TRANQUOCHUY202/DATN/ppDATN.pdf

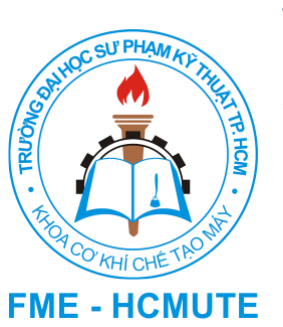
[picture p1: figure]
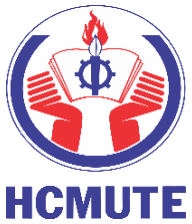
[picture p2: figure]

# ĐỀ TÀI: THIẾT KẾ, CHẾ TẠO BO MẠCH GIÁM SÁT NHIỆT ĐỘ VÀ ĐỘ ẨM CHO BUỒNG HẤP

### TRƯỜNG ĐẠI HỌC SƯ PHẠM KỸ THUẬT TP.HỒ CHÍ MINH KHOA CƠ KHÍ CHẾ TẠO MÁY BỘ MÔN CƠ ĐIỆN TỬ

## ĐỒ ÁN TỐT NGHIỆP

Sinh viên thực hiện:
Trần Hạo Đông Trần Quốc Huy Trương Đình Như | --- | 20146166 20146495 20146509

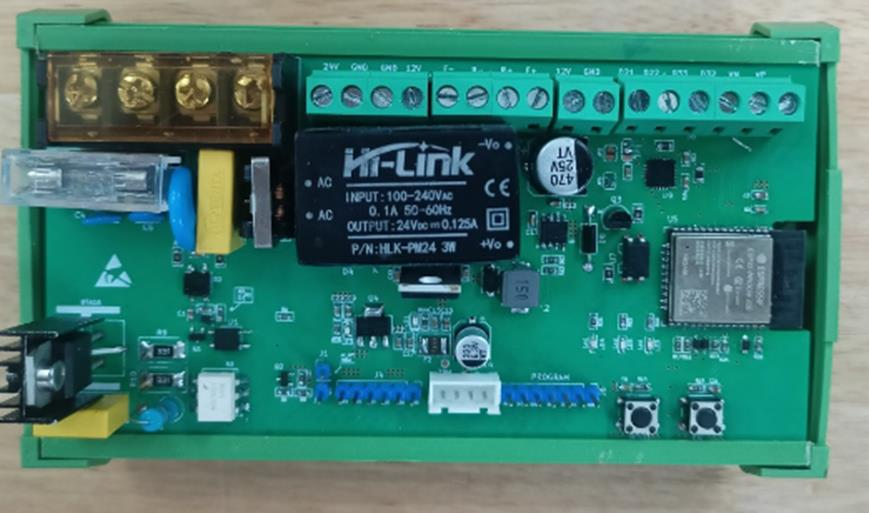
[picture p3: figure]

Tp. Hồ Chí Minh – Tháng 07/2024

Giảng viên hướng dẫn: ThS Dương Thế Phong

## NỘI DUNG THỰC HIỆN

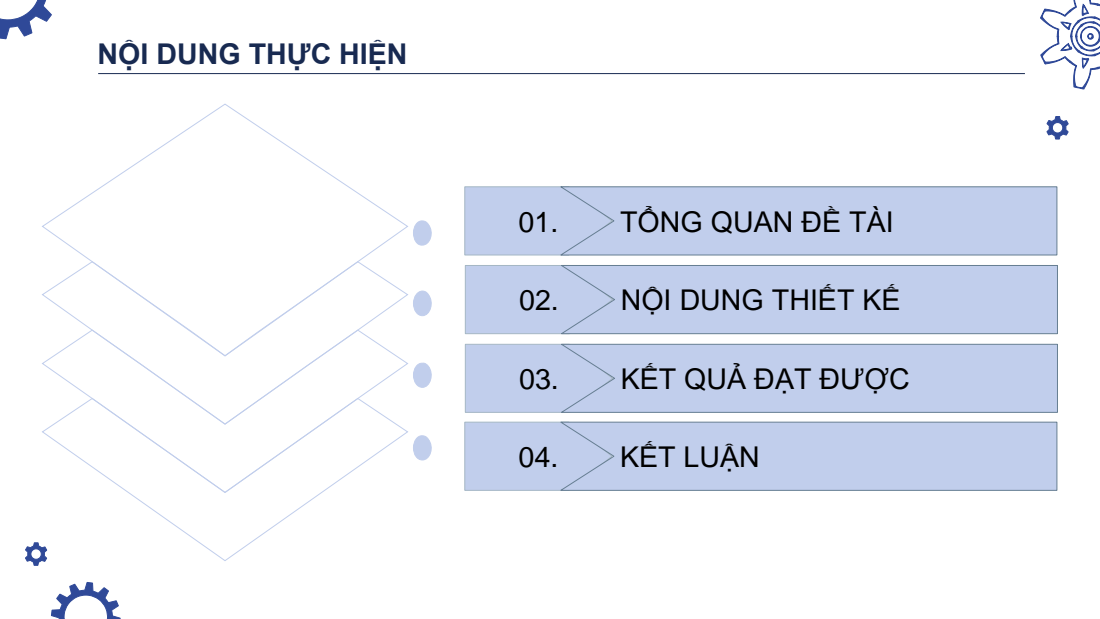
[picture p4: page 2]
04. KẾT LUẬN

01. TỔNG QUAN ĐỀ TÀI

02. NỘI DUNG THIẾT KẾ

03. KẾT QUẢ ĐẠT ĐƯỢC

## 01. TỔNG QUAN ĐỀ TÀI

Tổng Quan

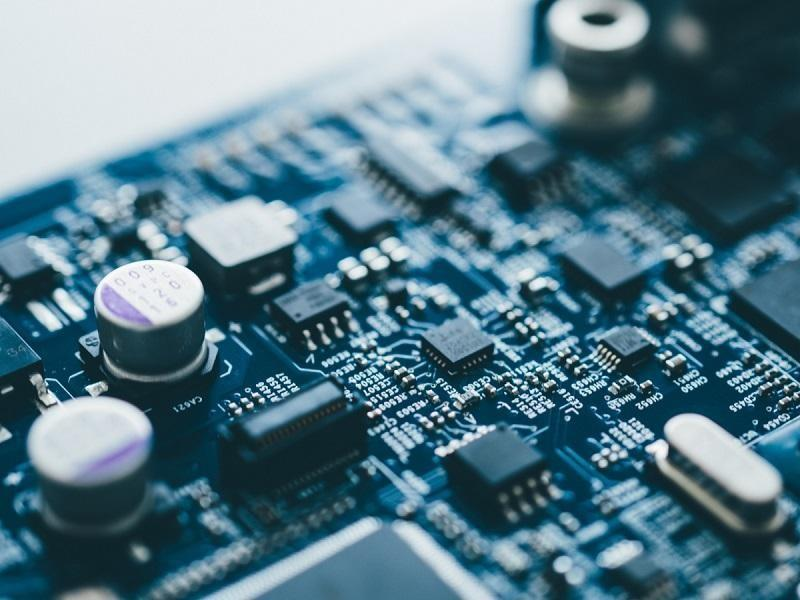
[picture p5: figure]

## 01. TỔNG QUAN ĐỀ TÀI

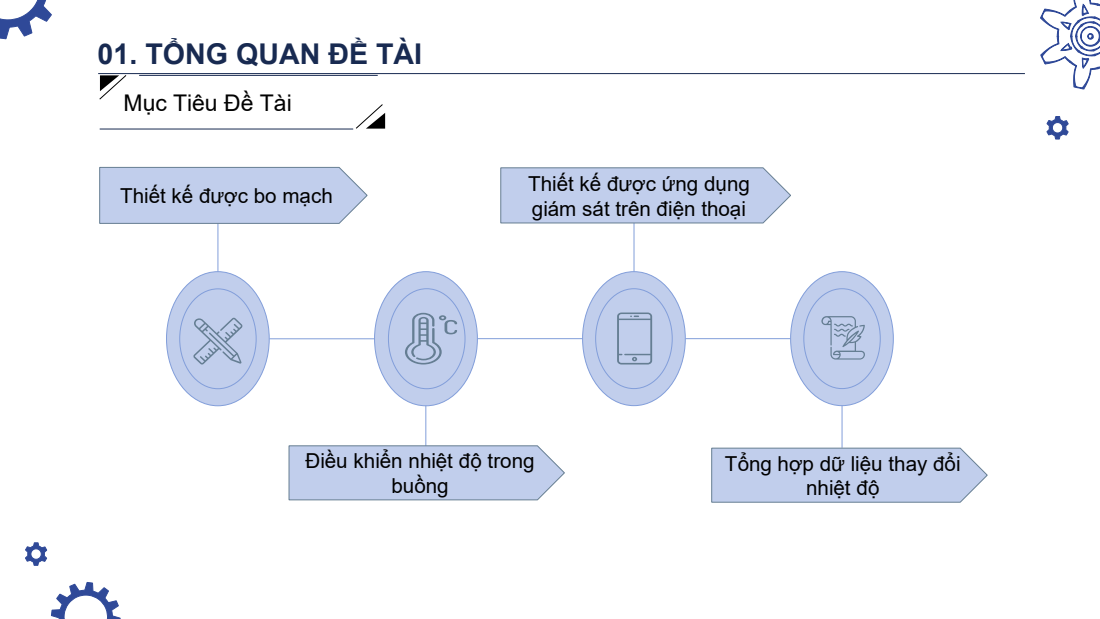
[picture p6: page 4]
buồng; nhiệt độ

Mục Tiêu Đề Tài

Thiết kế được ứng dụng
giám sát trên điện thoại

Thiết kế được bo mạch

Điều khiển nhiệt độ trong

Tổng hợp dữ liệu thay đổi

## 01. TỔNG QUAN ĐỀ TÀI

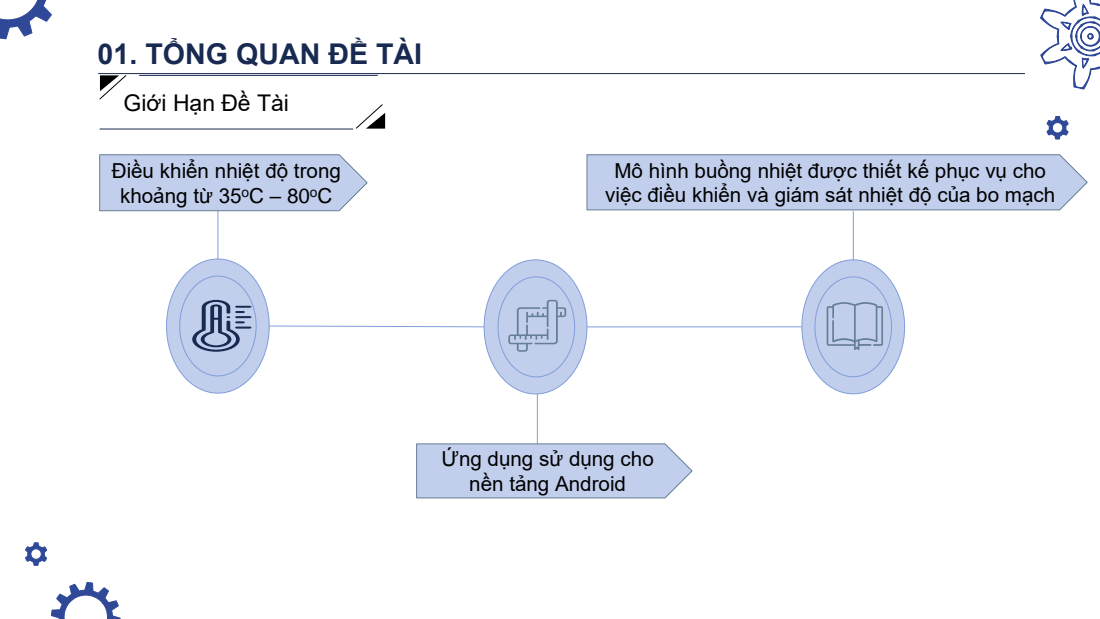
[picture p7: page 5]

Giới Hạn Đề Tài

Điều khiển nhiệt độ trong
khoảng từ 35oC – 80oC

Mô hình buồng nhiệt được thiết kế phục vụ cho
việc điều khiển và giám sát nhiệt độ của bo mạch

Ứng dụng sử dụng cho
nền tảng Android

## 02. NỘI DUNG THIẾT KẾ

Phương Án Thiết Kế

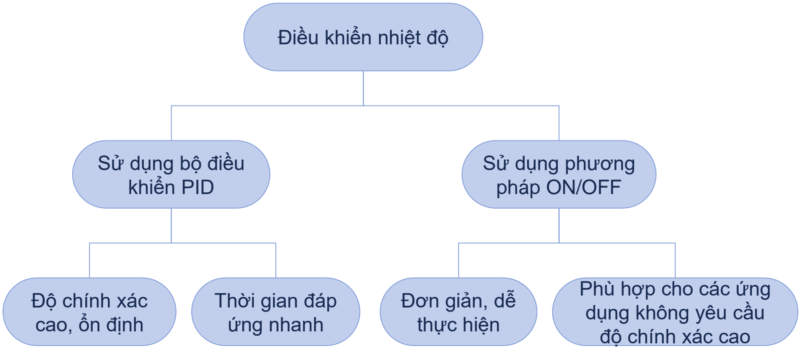
[picture p8: figure]
Độ chính xác cao, ổn định; Thời gian đáp ứng nhanh; Đơn giản, dễ thực hiện; Phù hợp cho các ứng dụng không yêu cầu độ chính xác cao; Sử dụng phương pháp ON/OFF; Sử dụng bộ điều khiển PID; Điều khiển nhiệt độ

## 02. NỘI DUNG THIẾT KẾ

Mô Hình Buồng Nhiệt

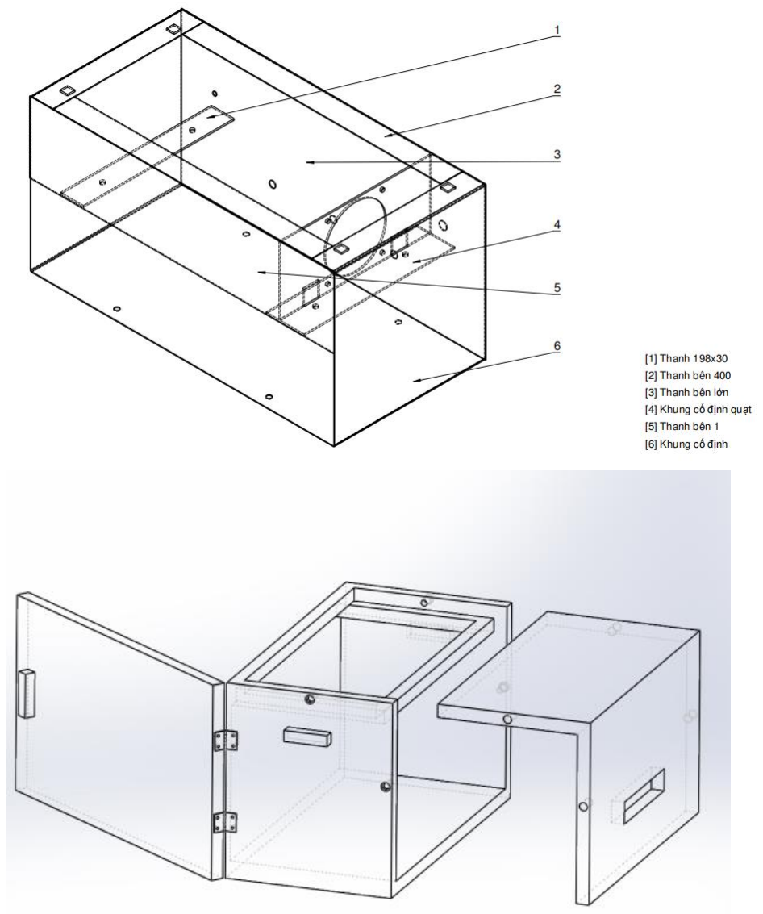
[picture p9: figure]

Mô hình được thiết kế với 3 lớp:

- Lớp vỏ trong: được làm bằng kim loại chịu nhiệt, nơi diễn ra quá trình gia nhiệt.
- Lớp cách nhiệt: Nằm giữa lớp vỏ trong và vỏ ngoài, có chức năng cách nhiệt môi trường bên trong với bên ngoài.
- Lớp vỏ ngoài: Vỏ ngoài được làm từ gỗ đã qua xử lí, đóng góp thêm vào việc cách nhiệt cho buồng.

## 02. NỘI DUNG THIẾT KẾ

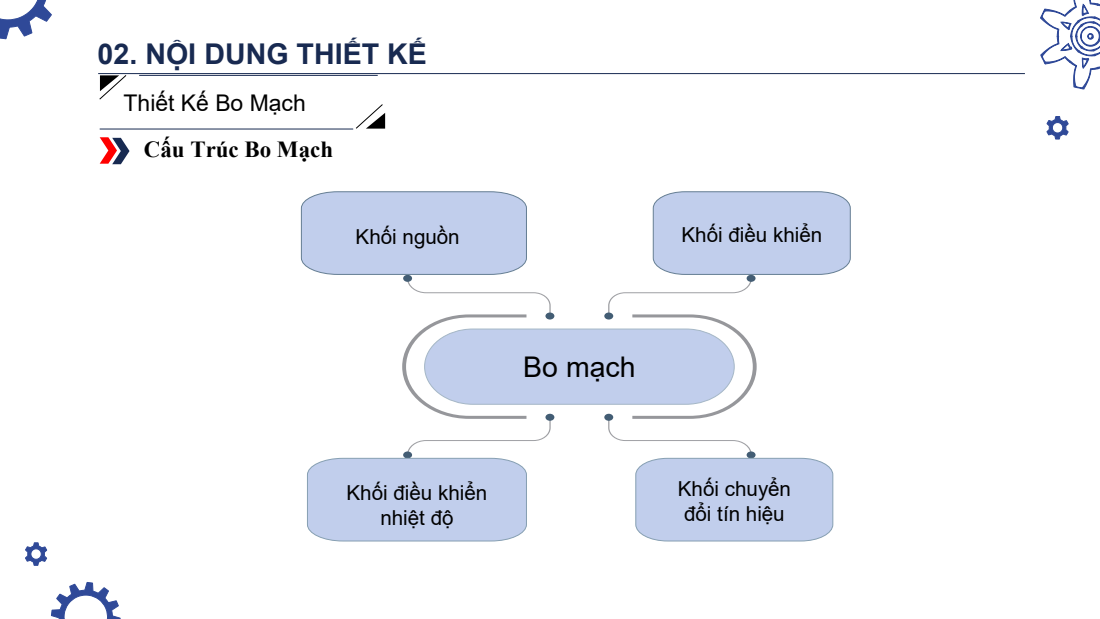
[picture p10: page 8]
Bo mạch; Khối nguồn; Khối điều khiển

Thiết Kế Bo Mạch

Cấu Trúc Bo Mạch

Khối điều khiển
nhiệt độ

Khối chuyển
đổi tín hiệu

## 02. NỘI DUNG THIẾT KẾ

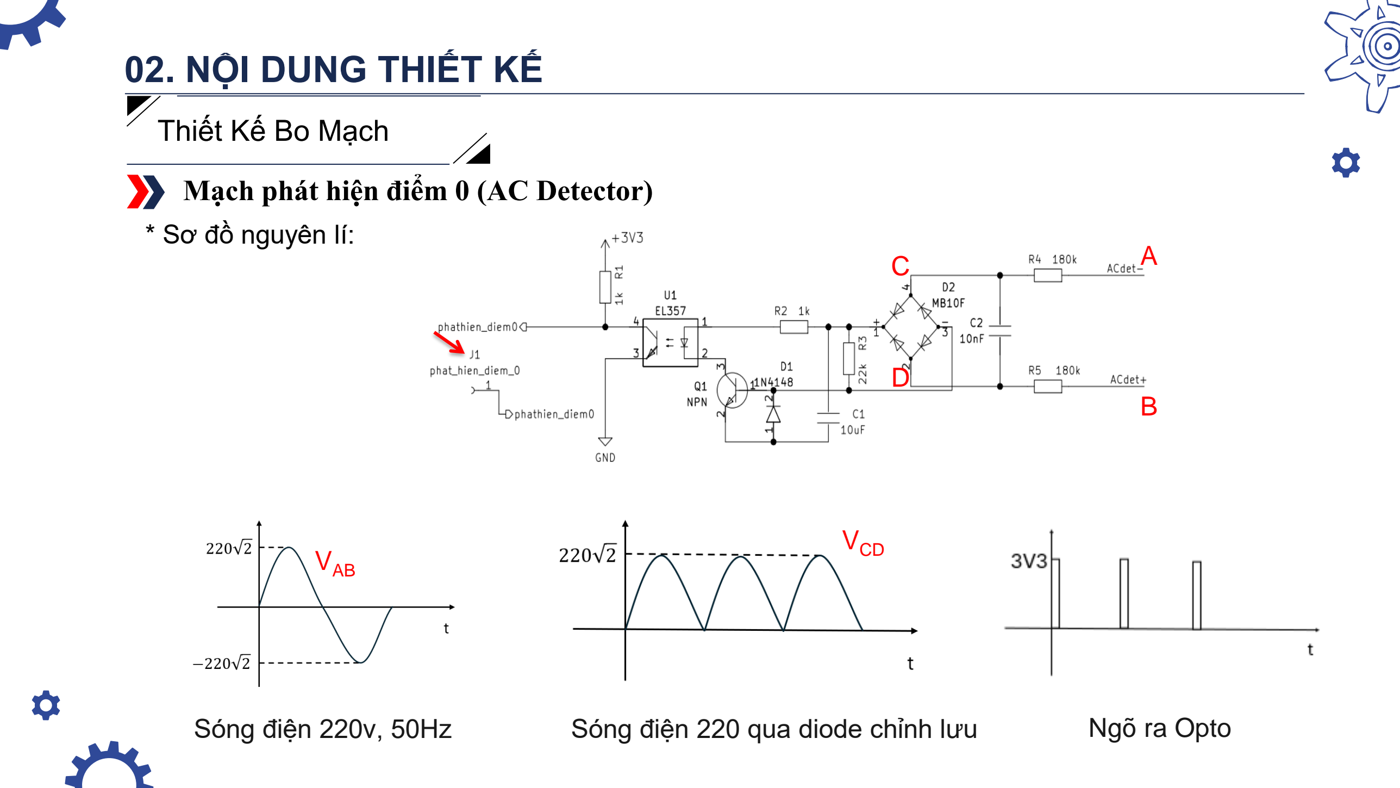
[picture p11: page 9]

Thiết Kế Bo Mạch

Mạch phát hiện điểm 0 (AC Detector)

* Sơ đồ nguyên lí:
A

B

C

D

Sóng điện 220v, 50Hz | Sóng điện 220 qua diode chỉnh lưu | Ngõ ra Opto

VAB

VCD

## 02. NỘI DUNG THIẾT KẾ

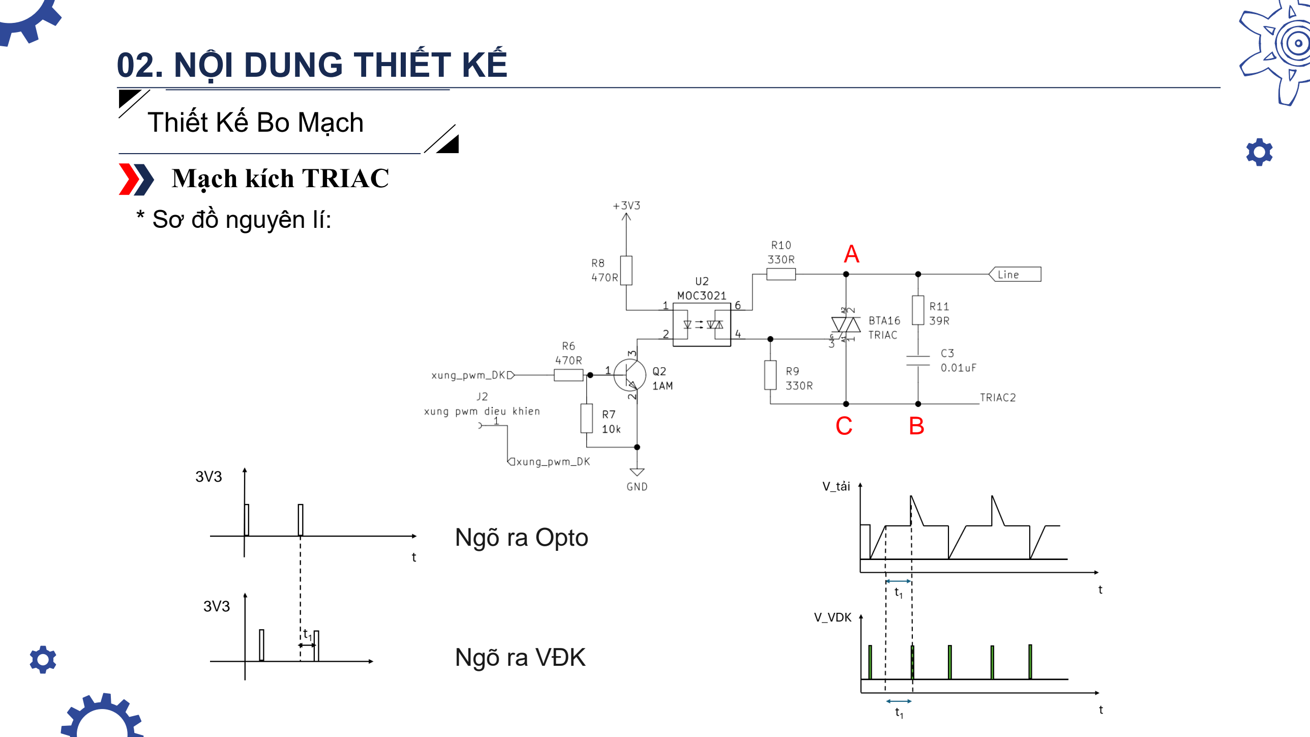
[picture p12: page 10]

Thiết Kế Bo Mạch

Mạch kích TRIAC
* Sơ đồ nguyên lí:
A

C B

Ngõ ra Opto

Ngõ ra VĐK

3V3

3V3

## 02. NỘI DUNG THIẾT KẾ

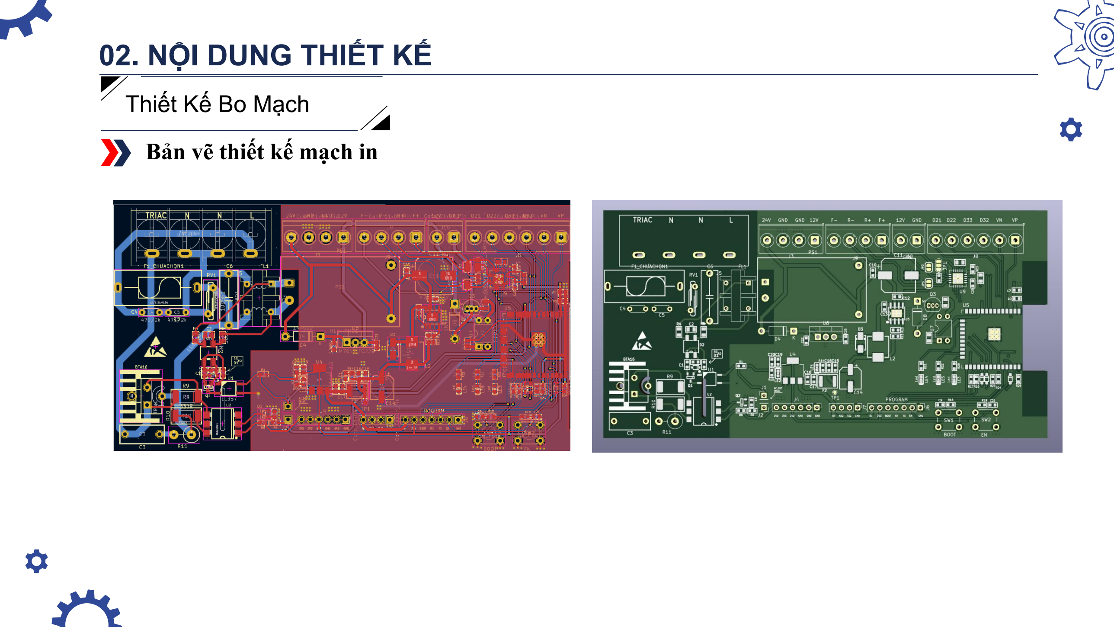
[picture p13: page 11]

Thiết Kế Bo Mạch

Bản vẽ thiết kế mạch in

## 02. NỘI DUNG THIẾT KẾ

Hệ Thống Điều Khiển

Sơ đồ khối hệ thống

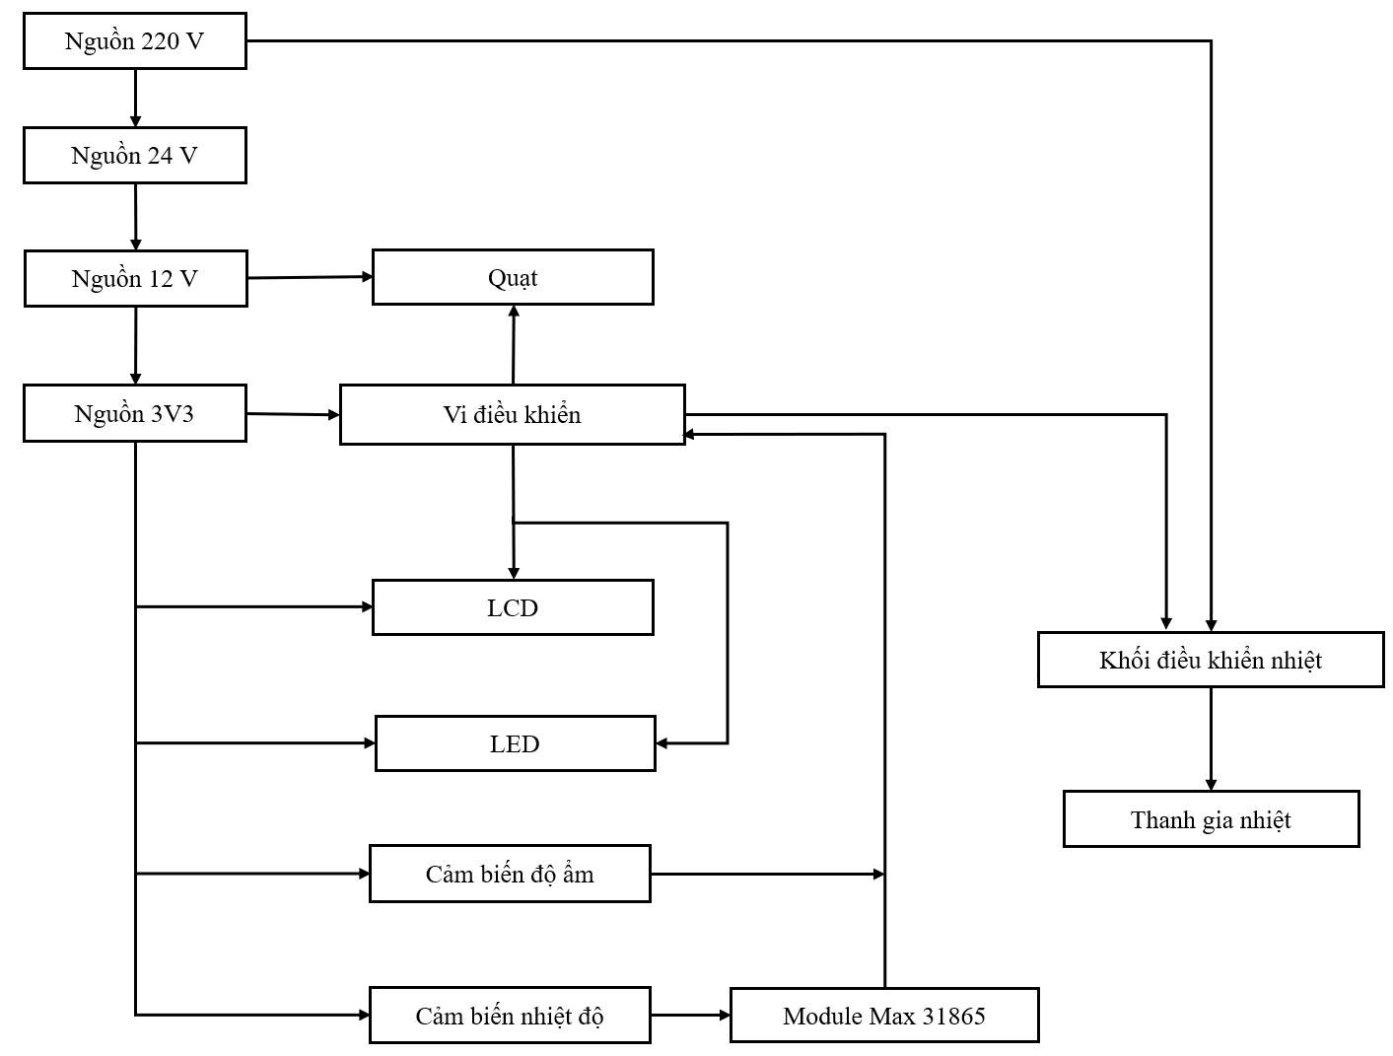
[picture p14: figure]

## 02. NỘI DUNG THIẾT KẾ

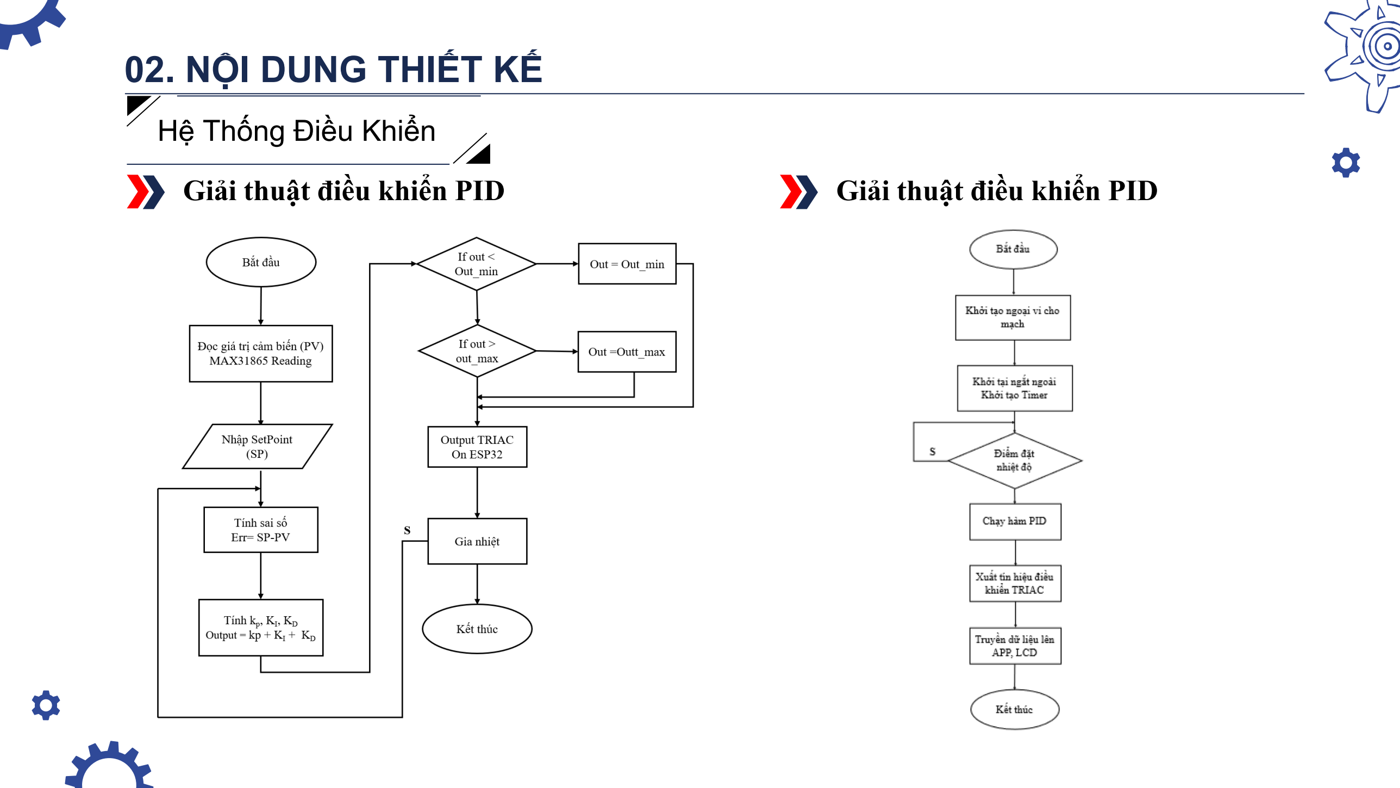
[picture p15: page 13]

Hệ Thống Điều Khiển

Giải thuật điều khiển PID | Giải thuật điều khiển PID

## 02. NỘI DUNG THIẾT KẾ

Hệ Thống Điều Khiển

Xây dựng ứng dụng

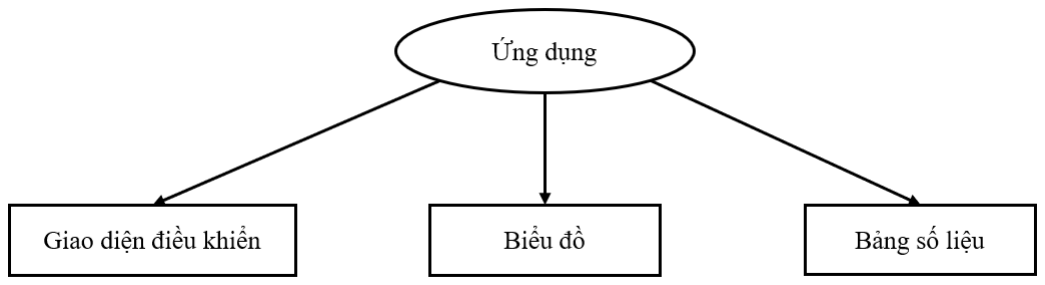
[picture p16: figure]

- Ứng dụng được xây dựng để truyền và nhận dữ liệu với hệ thống điều khiển qua nền tảng Firebase.
- Ứng dụng được thiết kế với 3 Tabs: màn hình điều khiển và giám sát, màn hình biểu thị biểu đồ và màn hình tổng hợp các giá trị

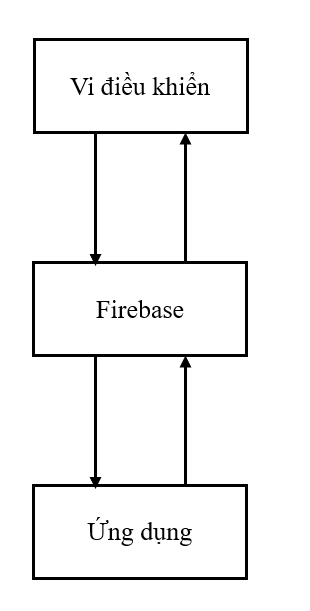
[picture p17: figure]

- Quá trình giao tiếp giữa ứng dụng và hệ thống điều khiển được thực hiện thông qua Firebase.

## 02. NỘI DUNG THIẾT KẾ

Hệ Thống Điều Khiển

Xây dựng ứng dụng

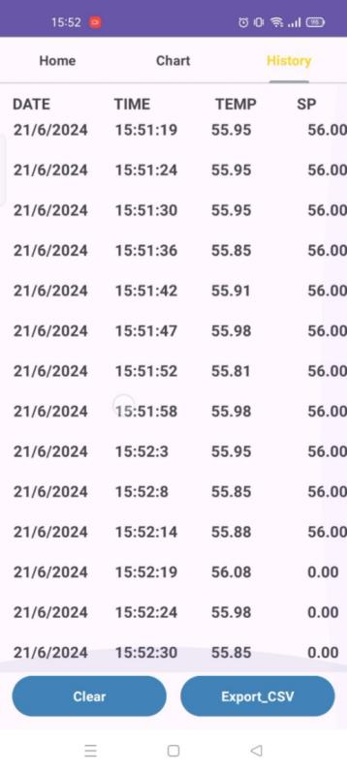
[picture p18: figure]
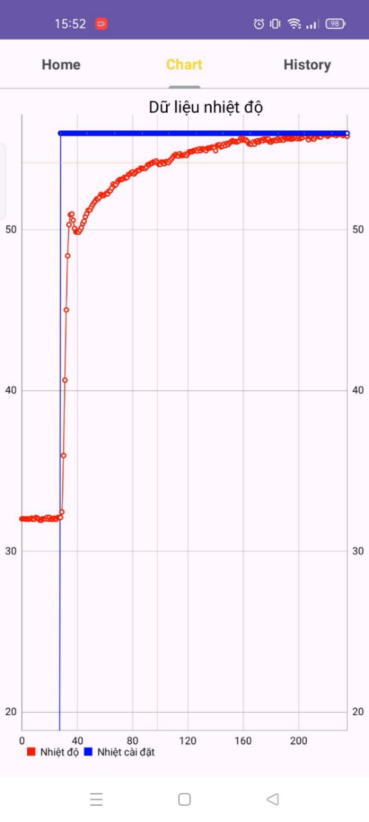
[picture p19: figure]
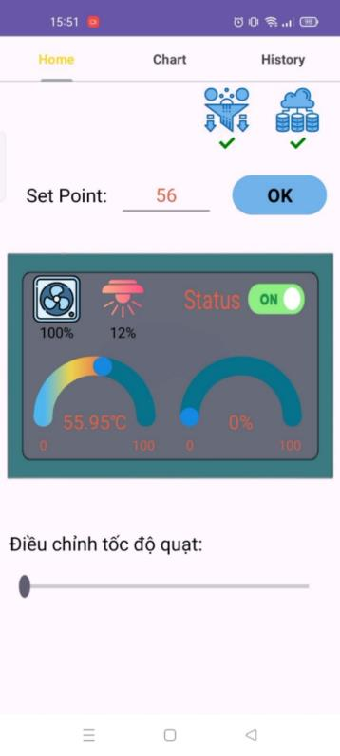
[picture p20: figure]

Màn hình điều khiển | Biểu đồ | Bảng dữ liệu

## 03. KẾT QUẢ ĐẠT ĐƯỢC

Mô Hình Tổng Quan

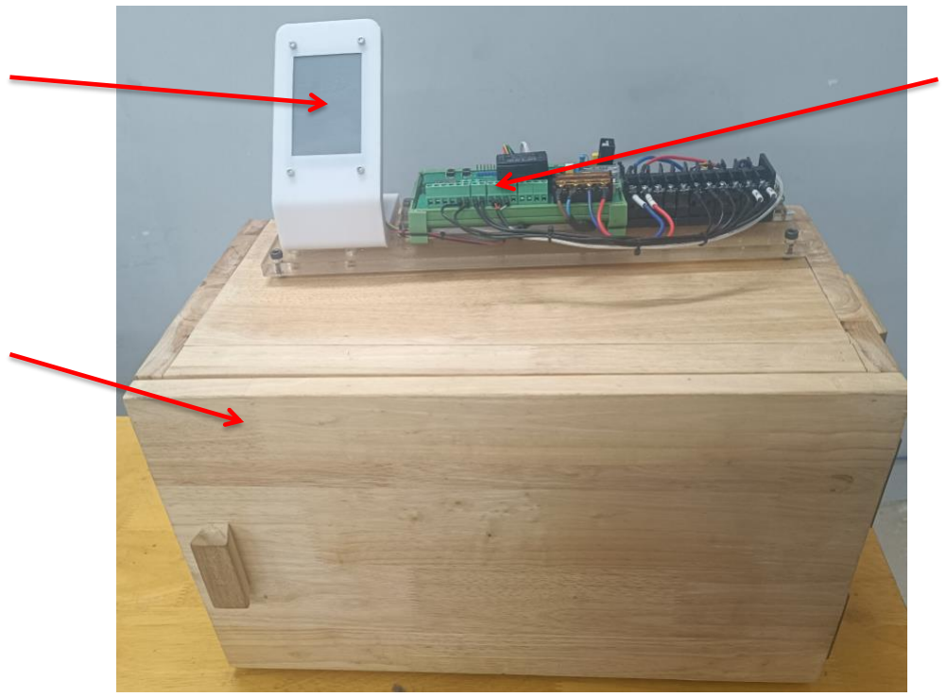
[picture p21: figure]

Mô hình buồng
nhiệt

Màn hình giám
sát

Bo mạch điều khiển
và giám sát

## 03. KẾT QUẢ ĐẠT ĐƯỢC

Dữ Liệu Thu Được

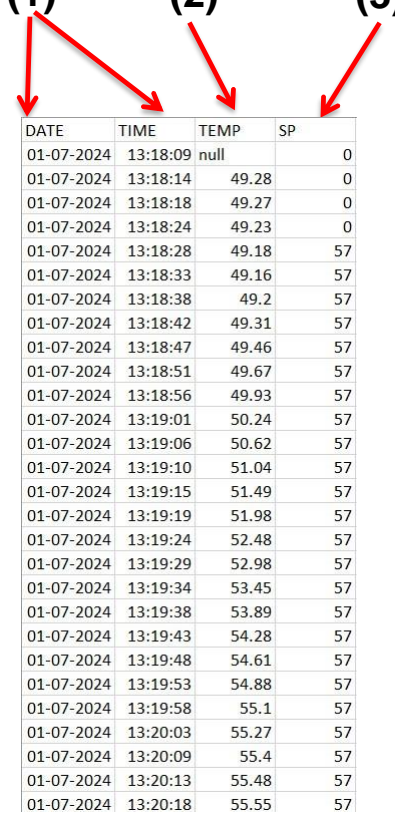
[picture p22: figure]

Bảng dữ liệu

- (1): Hiển thị thời gian điều khiển và giám sát giá trị nhiệt độ (bao gồm ngày và giờ).
- (2): Hiển thị giá trị nhiệt độ có trong buồng
- (3): Giá trị đặt để điều khiển nhiệt độ.
(1) | (2) | (3)

Biểu đồ

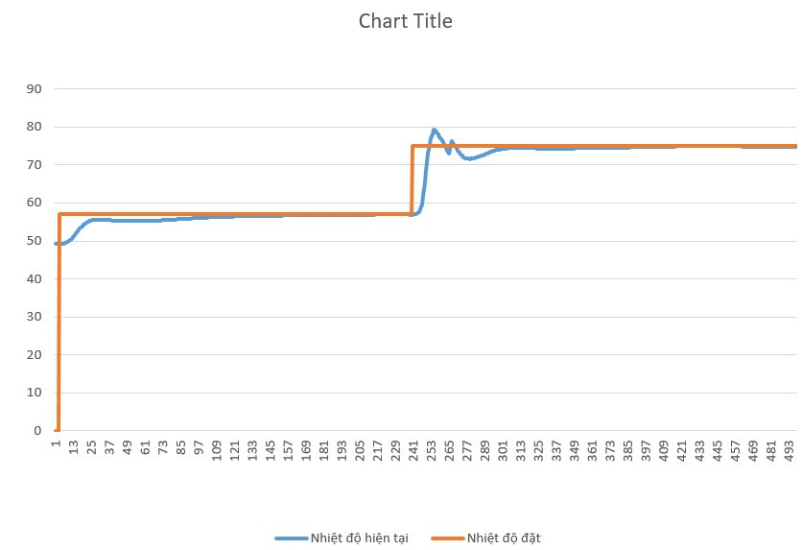
[picture p23: figure]

## 03. KẾT QUẢ ĐẠT ĐƯỢC

Dữ Liệu Thu Được

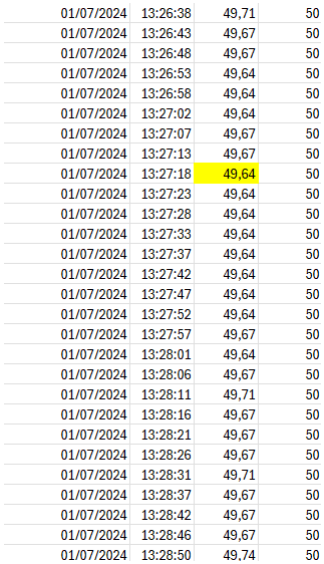
[picture p24: figure]

Sai số

* Từ số liệu thu được từ quá trình điều khiển và trả về từ cảm biến:

- Giá trị đặt: SP = 50
- Giá trị ổn định nhỏ nhất là: 49,64
- Giá trị ổn định lớn nhất là: 50,5

## 04. KẾT LUẬN

ĐẠT ĐƯỢC

CHƯA ĐẠT ĐƯỢC

HƯỚNG PHÁT TRIỂN

- Chương trình chưa được tối ưu nhất.
- Thời gian trễ còn lớn khi đưa dữ liệu lên ứng dụng.
- Tối ưu hoá chương trình.
- Xây dựng ứng dụng sử dụng được cho nền tảng iOS.
- Thiết kế được bo mạch điều chỉnh được nhiệt độ trong buồng.
- Giám sát và tổng hợp dữ liệu qua ứng dụng điện thoại.

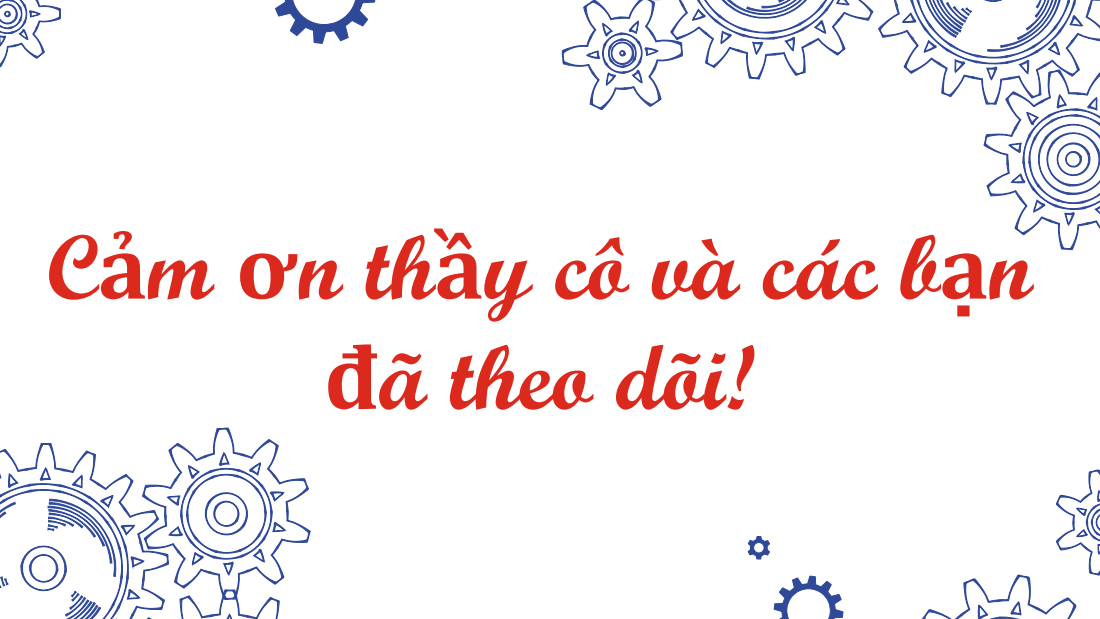
[picture p25: page 20]

Cảm ơn thầy cô và các bạn

đã theo dõi!
