TRANQUOCHUY202/DATN/lo_say/lap_rap_24_4.SLDASM

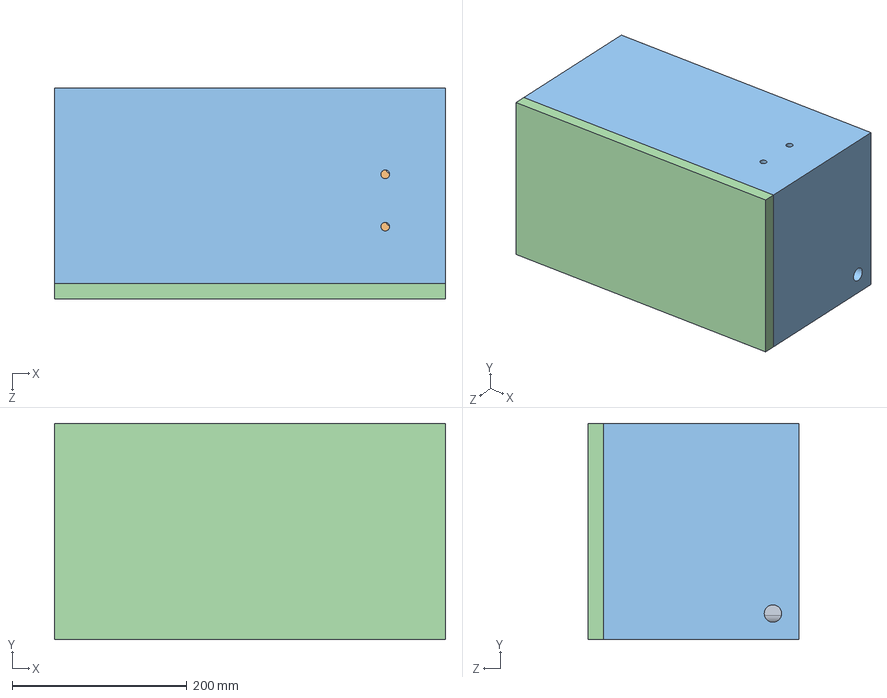
[picture p26: CAD file, 2024-08-06]
lo_say/lap_rap_24_4.SLDASM
448.0 x 248.0 x 242.0 mm
vo_trong_lo_say_23_4
nap_tham_23_4
vo_ngoai_lo_say_24_4
cua_lo_say_24_4
thanh_chu_u x 2
tru_6mm x 4
