TRANQUOCHUY202/DATN/lo_say/tru_6mm.SLDPRT

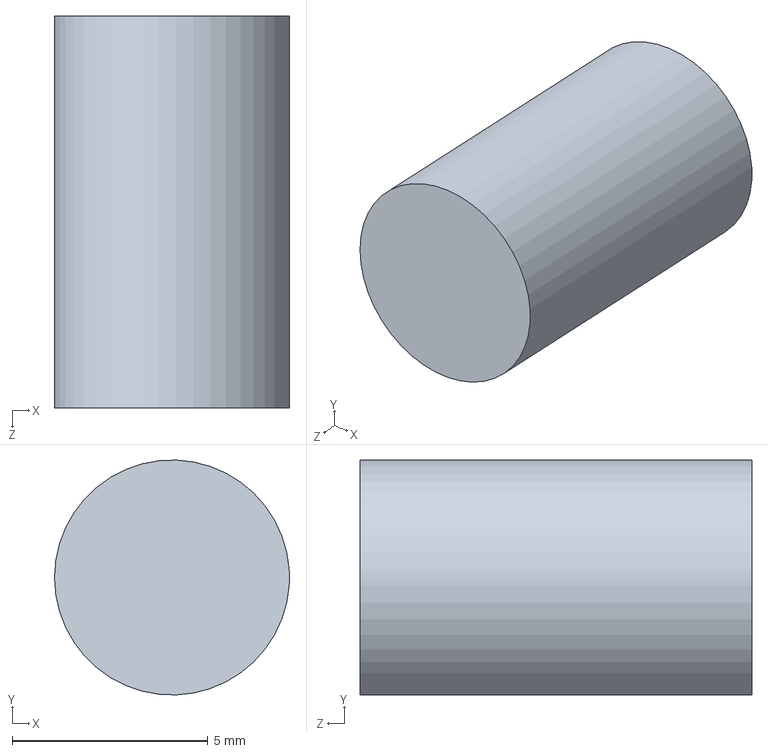
[picture p27: CAD file, 2024-08-06]
lo_say/tru_6mm.SLDPRT
6.00 x 6.00 x 10.0 mm
