TRANQUOCHUY202/DATN/mach_kich_triac_final/mach_kich_triac_final/mach_kich_triac/file_dowm_ve/FILE_3D_DOWNLOAD/MB10F-13.step

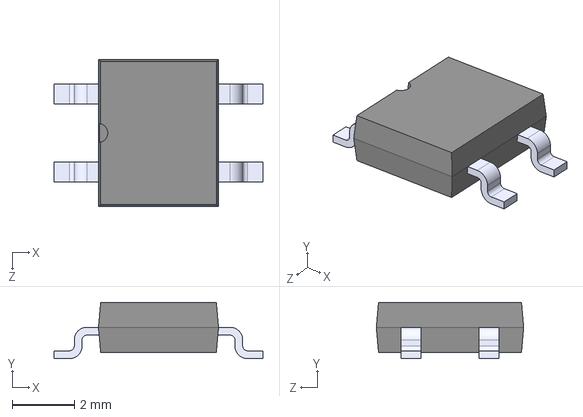
[picture p28: CAD file, 2024-08-06]
mach_kich_triac_final/mach_kich_triac_final/mach_kich_triac/file_dowm_ve/FILE_3D_DOWNLOAD/MB10F-13.step
6.70 x 1.80 x 4.72 mm
