TRANQUOCHUY202/DATN/mach_kich_triac_final/mach_kich_triac_final/mach_kich_triac/file_dowm_ve/MMBT_1M/MMBT3904T.step

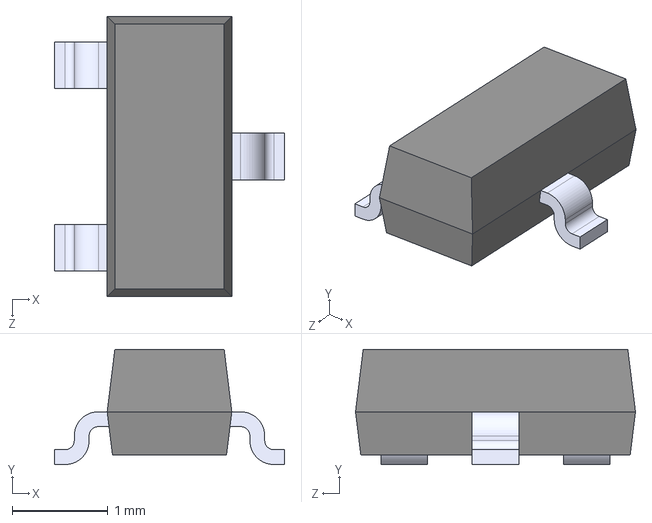
[picture p29: CAD file, 2024-08-06]
mach_kich_triac_final/mach_kich_triac_final/mach_kich_triac/file_dowm_ve/MMBT_1M/MMBT3904T.step
2.40 x 1.20 x 2.92 mm
