TRANQUOCHUY202/DATN/lo_say/vo_trong_lo_say_23_4.SLDPRT

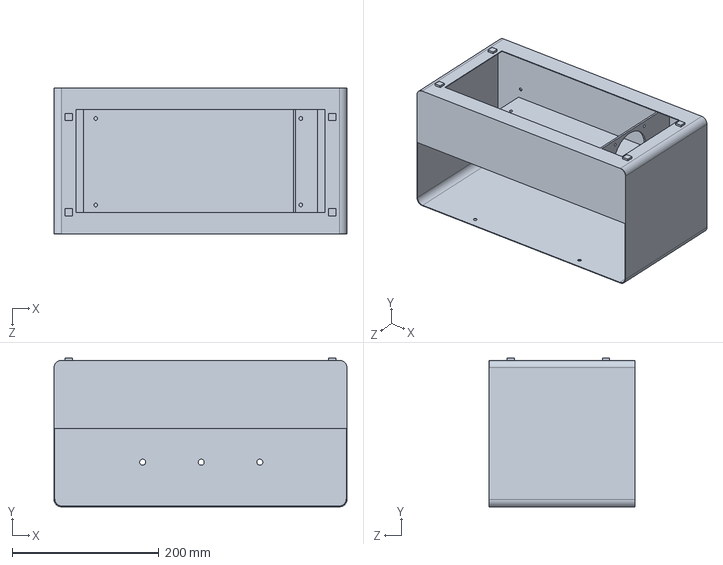
[picture p30: CAD file, 2024-08-06]
lo_say/vo_trong_lo_say_23_4.SLDPRT
400.0 x 203.0 x 200.0 mm
