TRANQUOCHUY202/DATN/mach_kich_triac_final/mach_kich_triac_final/mach_kich_triac/file_dowm_ve/FILE_3D_DOWNLOAD/BTA16-600B.step

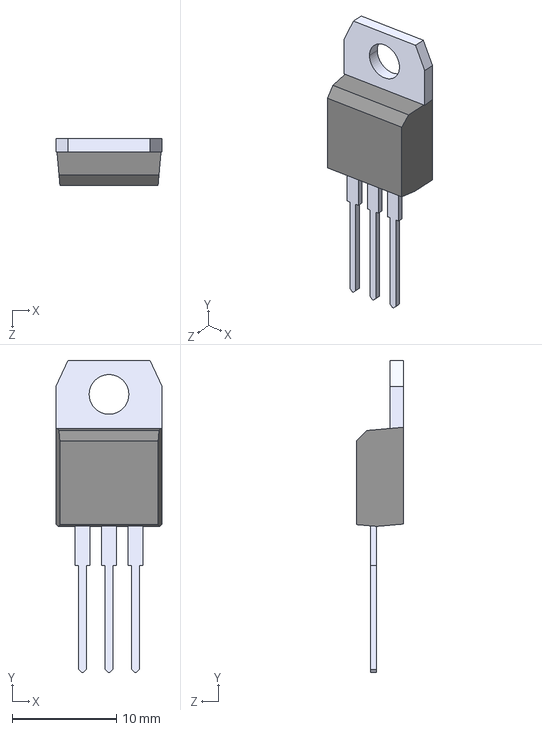
[picture p31: CAD file, 2024-08-06]
mach_kich_triac_final/mach_kich_triac_final/mach_kich_triac/file_dowm_ve/FILE_3D_DOWNLOAD/BTA16-600B.step
10.2 x 29.9 x 4.50 mm
