TRANQUOCHUY202/DATN/lo_say/nap_tham_23_4.SLDPRT

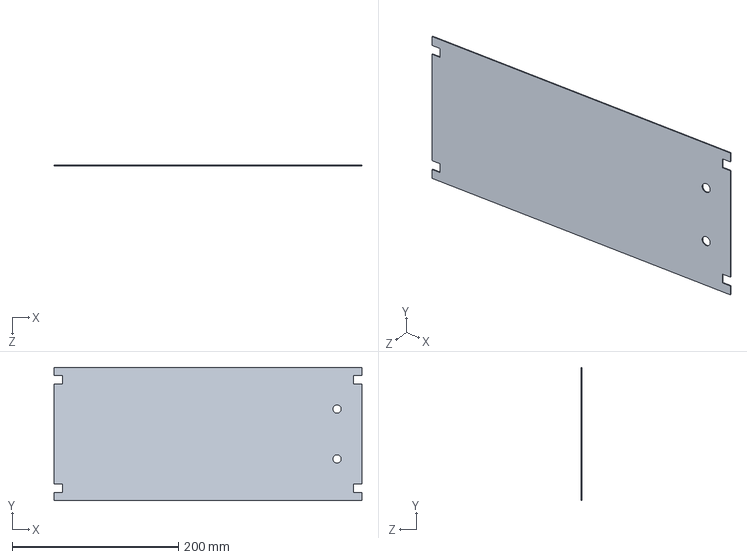
[picture p32: CAD file, 2024-08-06]
lo_say/nap_tham_23_4.SLDPRT
370.0 x 160.0 x 1.00 mm
