TRANQUOCHUY202/DATN/lo_say/vo_ngoai_lo_say_24_4.SLDPRT

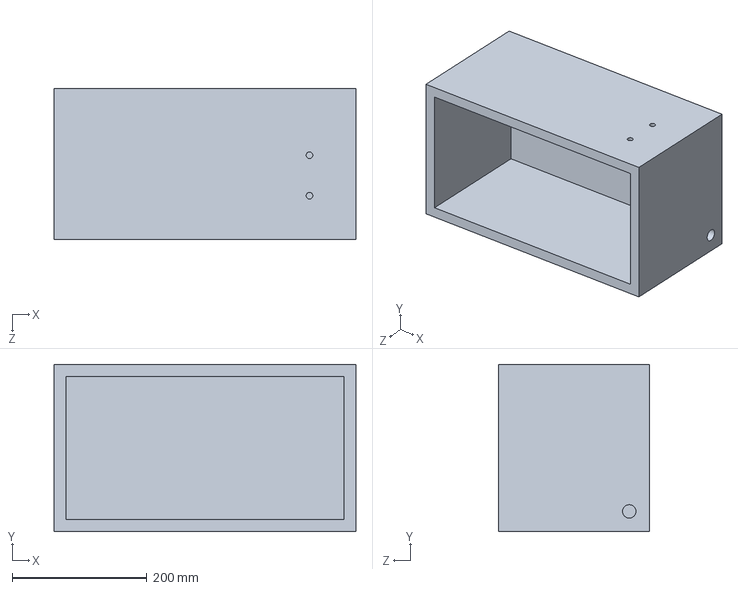
[picture p33: CAD file, 2024-08-06]
lo_say/vo_ngoai_lo_say_24_4.SLDPRT
448.0 x 248.0 x 224.0 mm
