TRANQUOCHUY202/DATN/lo_say/cua_lo_say_24_4.SLDPRT

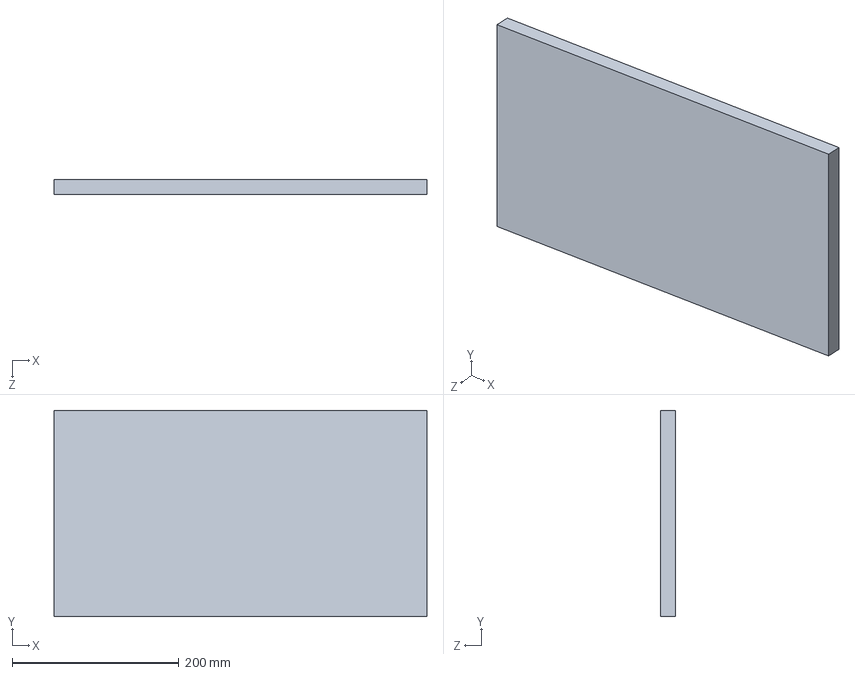
[picture p34: CAD file, 2024-08-06]
lo_say/cua_lo_say_24_4.SLDPRT
448.0 x 248.0 x 18.0 mm
