TRANQUOCHUY202/DATN/lo_say/thanh_chu_u.SLDPRT

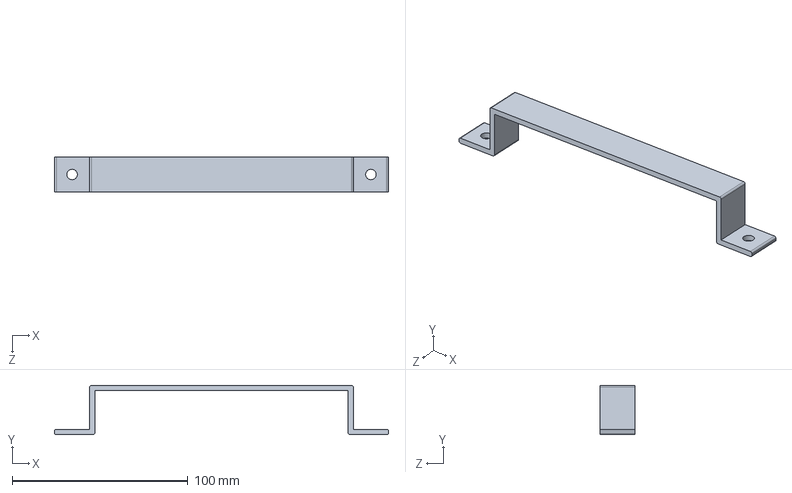
[picture p35: CAD file, 2024-08-06]
lo_say/thanh_chu_u.SLDPRT
190.0 x 28.0 x 20.0 mm
