TRANQUOCHUY202/DATN/board_dkth/board_dkth.kicad_pcb

## KiCad design board_dkth/board_dkth.kicad_pcb (2024-08-06)

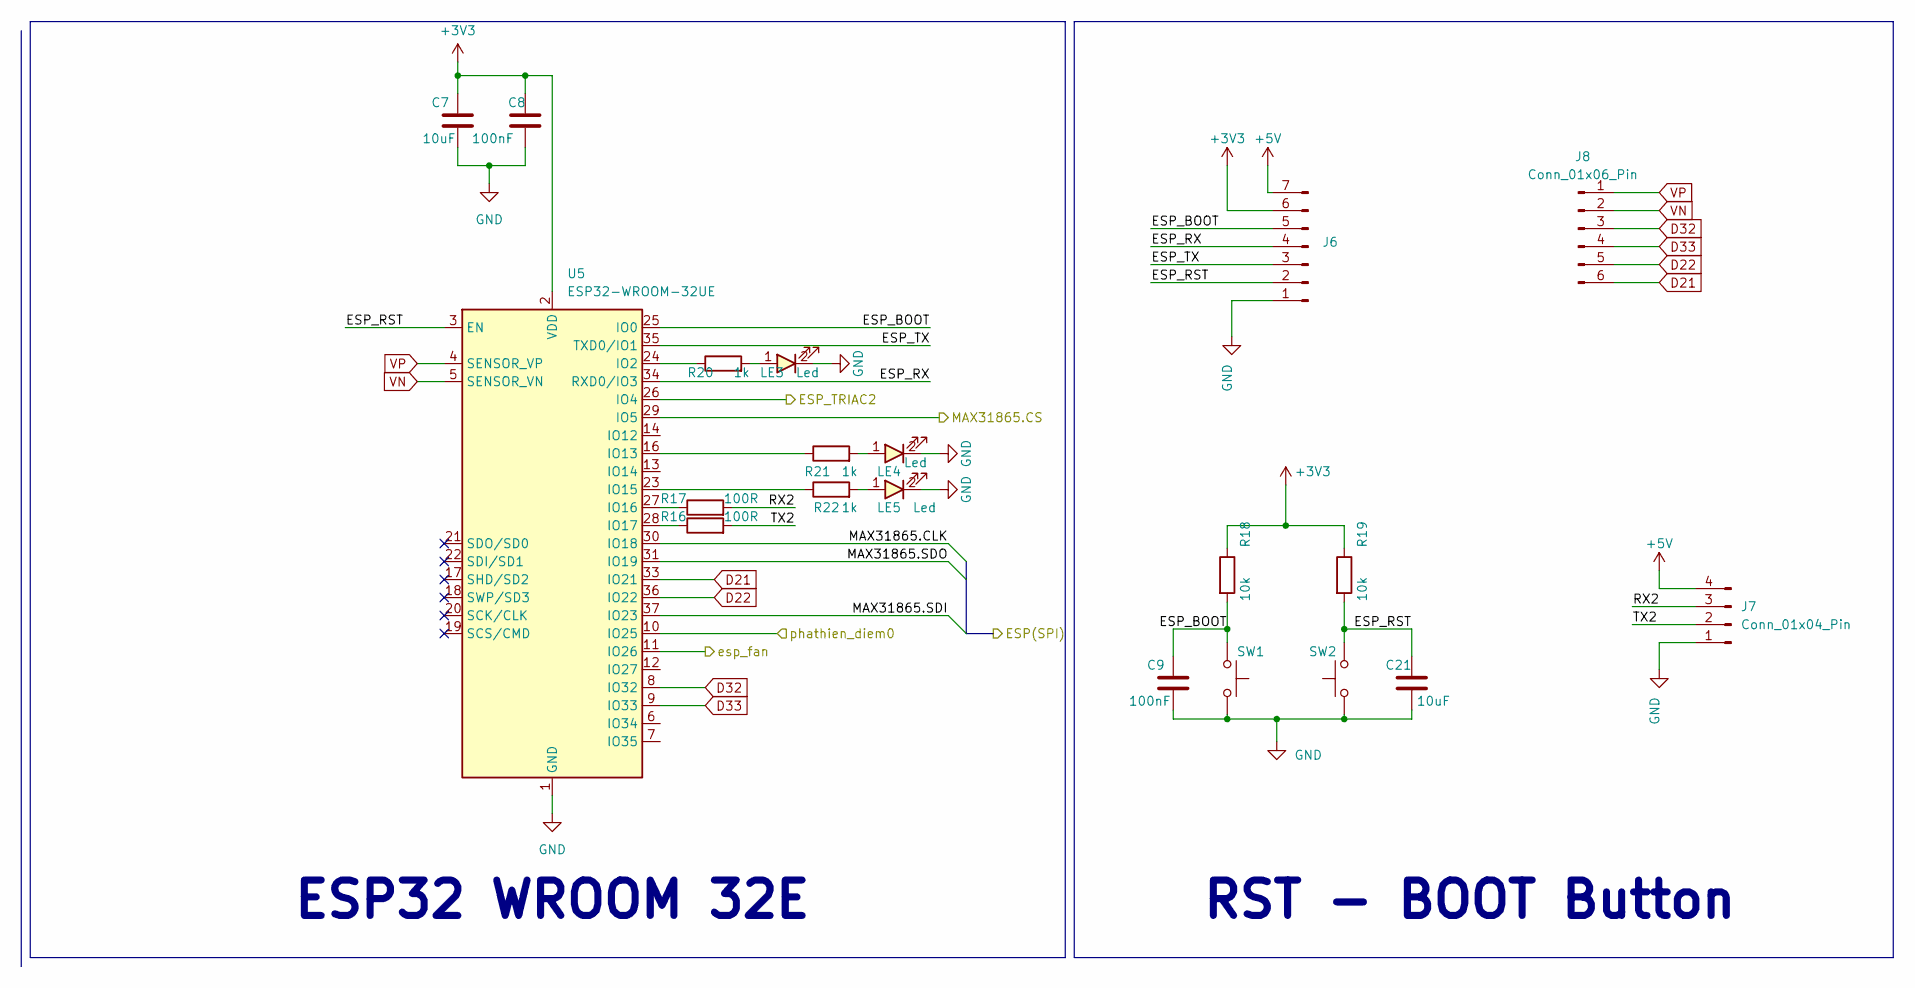
[picture p36: schematic esp32_wrom_32E.kicad_sch, Sơ đồ ESP32]

Parts:
C7, C21: 10uF; C_0603
C8, C9: 100nF; C_0603
J6: Conn_01x07_Pin; PinHeader_1x07_P2.54mm_Vertical
J7: Conn_01x04_Pin; PinHeader_1x04_P2.54mm_Vertical
J8: Conn_01x06_Pin; TerminalBlock_Phoenix_PT-1,5-6-5.0-H_1x06_P5.00mm_Horizontal
LE3, LE4, LE5: Led; LED_0603
R16, R17: 100R; R_0603
R18, R19: 10k; R_0603
R20, R21, R22: 1k; R_0603
SW1, SW2: SW_Push; SW_PUSH_6mm_H4.3mm
U5: ESP32-WROOM-32UE; ESP32-WROOM-32D

Connections:
+3.3V: C7.1, C8.1, J6.6, R18.1, R19.1, U5.2 (VDD); also elsewhere on the board
+5V: J6.7, J7.4; also elsewhere on the board
/esp32/ESP_BOOT: C9.1, J6.5, R18.2, SW1.1, U5.25 (IO0)
/esp32/ESP_RST: C21.1, J6.2, R19.2, SW2.2, U5.3 (EN)
/esp32/ESP_RX: J6.4, U5.34 (RXD0/IO3)
/esp32/ESP_TRIAC2: U5.26 (IO4); also elsewhere on the board
/esp32/ESP_TX: J6.3, U5.35 (TXD0/IO1)
/esp32/MAX31865.CLK: U5.30 (IO18)
/esp32/MAX31865.CS: U5.29 (IO5); also elsewhere on the board
/esp32/MAX31865.SDI: U5.37 (IO23)
/esp32/MAX31865.SDO: U5.31 (IO19)
/esp32/RX2: J7.3, R17.2
/esp32/TX2: J7.2, R16.2
/esp32/esp_fan: U5.11 (IO26); also elsewhere on the board
/esp32/phathien_diem0: U5.10 (IO25); also elsewhere on the board
D21: J8.6, U5.33 (IO21)
D22: J8.5, U5.36 (IO22)
D32: J8.3, U5.8 (IO32)
D33: J8.4, U5.9 (IO33)
GND: C7.2, C8.2, C9.2, C21.2, J6.1, J7.1, LE3.2, LE4.2, LE5.2, SW1.2, SW2.1, U5.1 (GND), U5.15 (GND), U5.38 (GND), U5.39 (GND); also elsewhere on the board
unnamed: LE3.1, R20.2
unnamed: LE4.1, R21.2
unnamed: LE5.1, R22.2
unnamed: R20.1, U5.24 (IO2)
unnamed: R21.1, U5.16 (IO13)
unnamed: R22.1, U5.23 (IO15)
unnamed: R17.1, U5.27 (IO16)
unnamed: R16.1, U5.28 (IO17)
VN: J8.2, U5.5 (SENSOR_VN)
VP: J8.1, U5.4 (SENSOR_VP)

Notes on the sheet:
ESP32 WROOM 32E
RST - BOOT Button

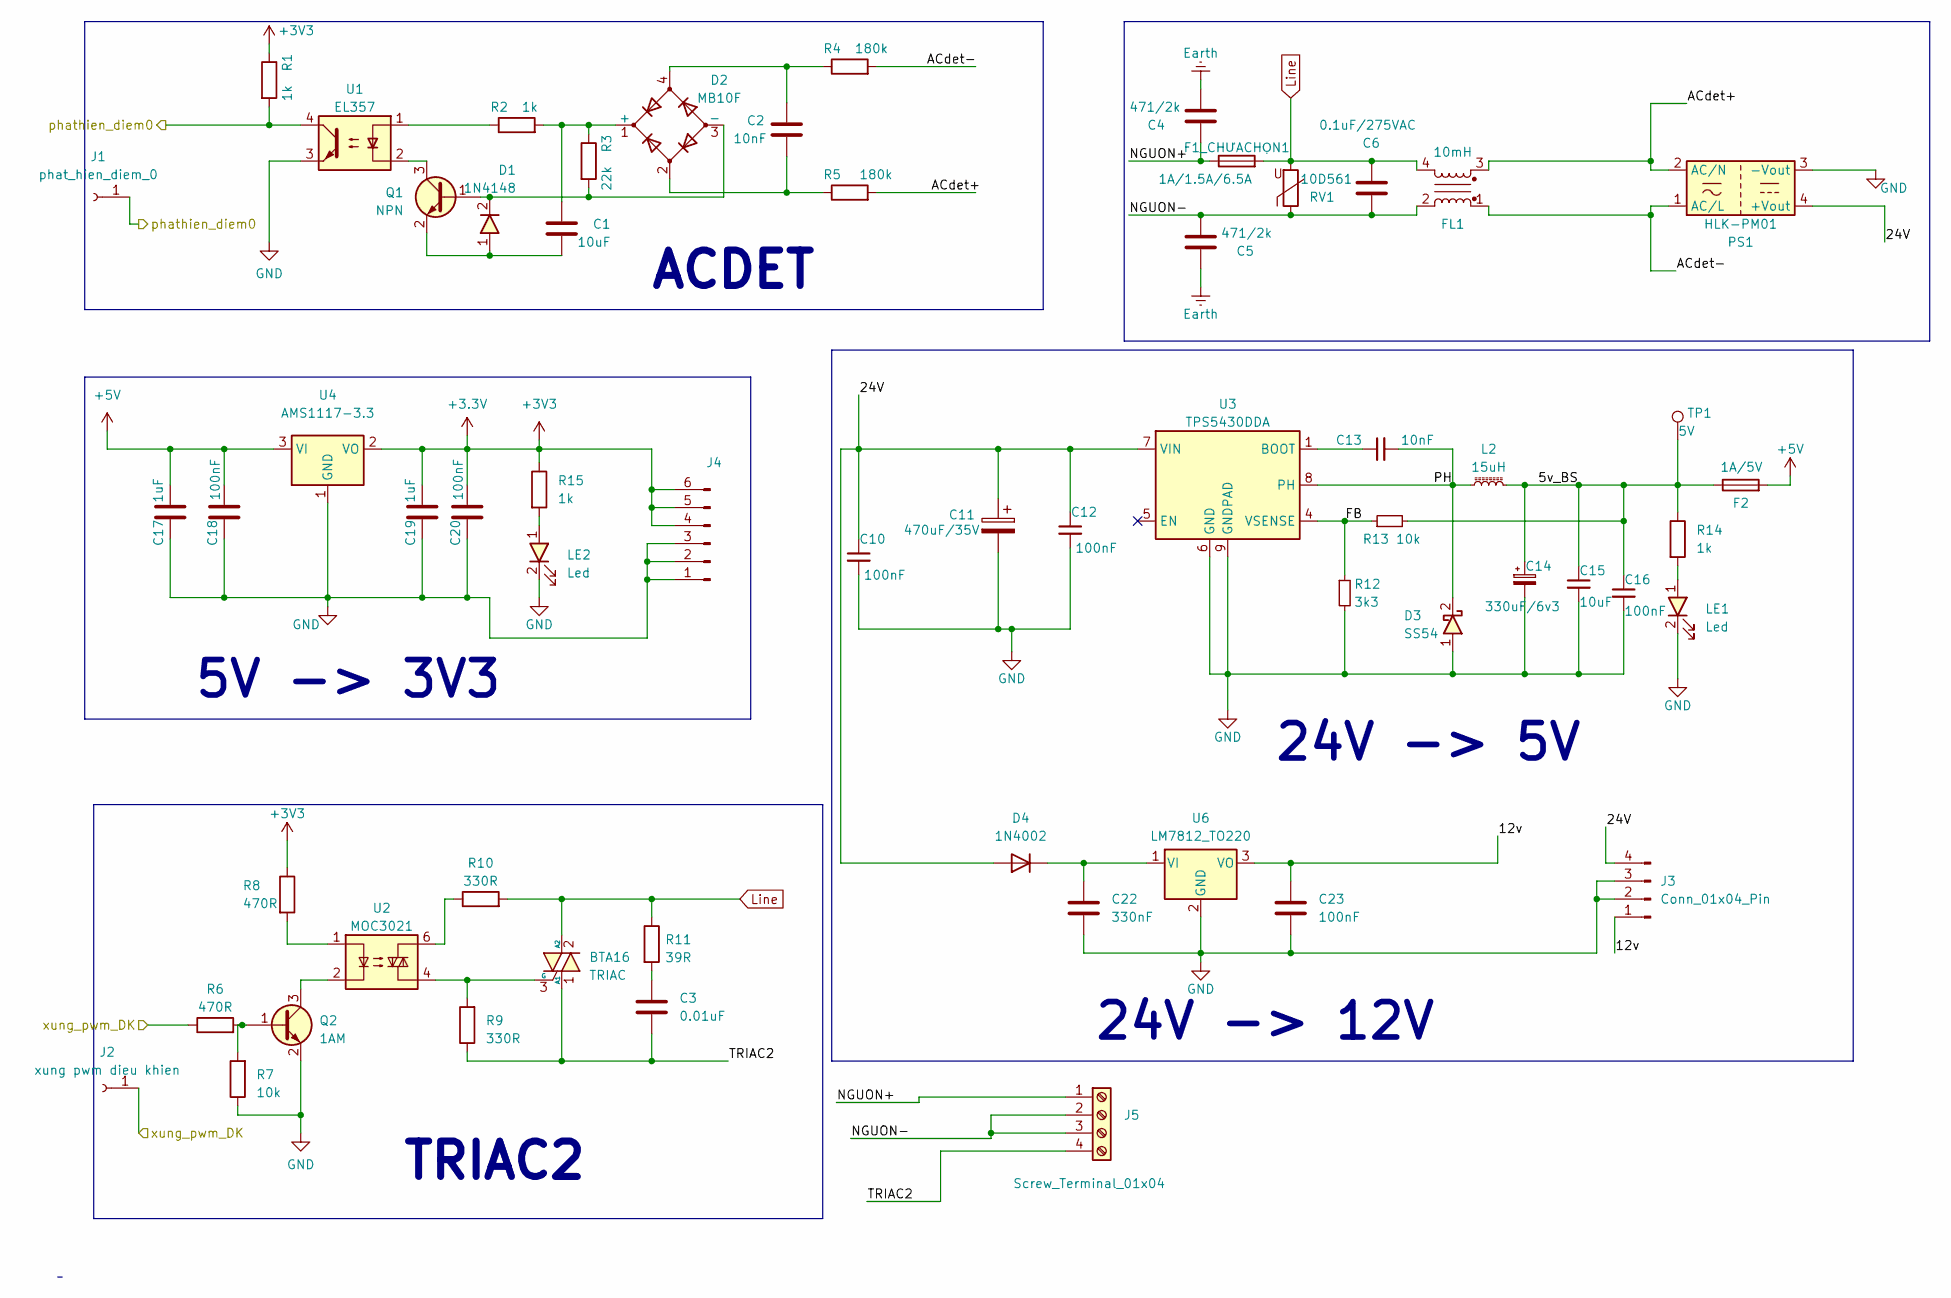
[picture p37: schematic tric_nguon.kicad_sch, Các sơ đồ mạch hạ nguồn và Triac]

Parts:
BTA16: TRIAC; TO-220-3_Vertical_heatsink_cutBoard
C1, C15: 10uF; C_0603
C2: 10nF; C_0805
C3: 0.01uF; C_Disc_D12.5mm_W5.0mm_P10.00mm
C4, C5: 471/2k; C_Disc_D4.3mm_W1.9mm_P5.00mm
C6: 0.1uF/275VAC; C_Rect_L16.5mm_W5.0mm_P15.00mm_MKT
C10, C12, C16, C18, C20, C23: 100nF; C_0603
C11: 470uF/35V; CP_Alu_SMD_10x10.5mm
C13: 10nF; C_0603
C14: 330uF/6v3; CP_Alu_SMD_6.3x7.7mm
C17, C19: 1uF; C_0603
C22: 330nF; C_0603
D1: 1N4148; D_SOD323
D2: MB10F; Bridge_MB10F-13
D3: SS54; Package-Diode-D_SMA
D4: 1N4002; D_DO-41_SOD81_P10.16mm_Horizontal
F1_CHƯACHỌN1: 1A/1.5A/6.5A; Fuse_HolderGlass5x20mm
F2: 1A/5V; Fuse_1812_4532Metric
FL1: 10mH; ACFilterChoke-UU9.8
J1: phat_hien_diem_0; PinHeader_1x01_P2.54mm_Vertical
J2: xung pwm dieu khien; PinHeader_1x01_P2.54mm_Vertical
J3: Conn_01x04_Pin; TerminalBlock_Phoenix_PT-1,5-4-5.0-H_1x04_P5.00mm_Horizontal
J4: Conn_01x06_Pin; PinHeader_1x06_P2.54mm_Vertical
J5: Screw_Terminal_01x04; TerminalBlock_Screw_HB9500_4P_P9.5mm
L2: 15uH; L_6.6x6.6
LE1, LE2: Led; LED_0603
PS1: HLK-PM01; PowerSuppy-ACDC-HLK_P01
Q1: NPN; SOT23-3
Q2: 1AM; SOT23-3
R1, R2, R14, R15: 1k; R_0603
R3: 22k; R_0603
R4, R5: 180k; R_0805
R6, R8: 470R; R_0603
R7, R13: 10k; R_0603
R9, R10: 330R; R_2512
R11: 39R; R_Axial_DIN0414_L11.9mm_D4.5mm_P5.08mm_Vertical
R12: 3k3; R_0603
RV1: 10D561; Varistor-RV-Disc-D12mm-W3.9mm-P7.5mm
TP1: 5V; TestPoint_Pad_D1.0mm
U1: EL357; OPTO_EL357N-G
U2: MOC3021; DIL06-SMD
U3: TPS5430DDA; SOIC8E(EXPOSED PAD)
U4: AMS1117-3.3; SOT-223-3_TabPin2
U6: LM7812_TO220; TO-220-3_Vertical

Connections:
+3.3V: C19.2, C20.2, J4.4, J4.5, J4.6, R1.1, R8.1, R15.1, U4.2 (VO); also elsewhere on the board
+5V: C17.2, C18.2, F2.2, U4.3 (VI); also elsewhere on the board
/5v_BS: C14.1, C15.1, C16.1, F2.1, L2.2, R13.2, R14.1, TP1.1
/FB: R12.1, R13.1, U3.4 (VSENSE)
/NGUON+: C4.1, F1_CHƯACHỌN1.1, J5.1
/PH: C13.2, D3.2, L2.1, U3.8 (PH)
/esp32/ESP_TRIAC2: J2.1, R6.1; also elsewhere on the board
/esp32/phathien_diem0: J1.1, R1.2, U1.4; also elsewhere on the board
/triac+nguon/12v: C23.1, J3.1, U6.3 (VO)
/triac+nguon/24V: C10.1, C11.1, C12.1, D4.2 (A), J3.4, PS1.4 (+Vout), U3.7 (VIN)
/triac+nguon/ACdet+: FL1.3, PS1.2 (AC/N), R5.2
/triac+nguon/ACdet-: FL1.1, PS1.1 (AC/L), R4.2
/triac+nguon/NGUON-: C5.2, C6.1, FL1.2, J5.2, J5.3, RV1.1
/triac+nguon/TRIAC2: BTA16.1 (A1), C3.2, J5.4, R9.1
Earth: C4.2, C5.1
GND: C10.2, C11.2, C12.2, C14.2, C15.2, C16.2, C17.1, C18.1, C19.1, C20.1, C22.2, C23.2, D3.1, J3.2, J3.3, J4.1, J4.2, J4.3, LE1.2, LE2.2, PS1.3 (-Vout), Q2.2 (E), R7.1, R12.2, U1.3, U3.6 (GND), U3.9 (GNDPAD), U4.1 (GND), U6.2 (GND); also elsewhere on the board
Line: BTA16.2 (A2), C6.2, F1_CHƯACHỌN1.2, FL1.4, R10.2, R11.1, RV1.2
unnamed: BTA16.3 (G), R9.2, U2.4
unnamed: C2.1, D2.4, R4.1
unnamed: C2.2, D2.2, R5.1
unnamed: C3.1, R11.2
unnamed: C1.1, D2.1 (+), R2.2, R3.1
unnamed: D1.2, D2.3 (-), Q1.1 (B), R3.2
unnamed: C22.1, D4.1 (K), U6.1 (VI)
unnamed: LE1.1, R14.2
unnamed: LE2.1, R15.2
unnamed: Q1.3 (C), U1.2
unnamed: C1.2, D1.1, Q1.2 (E)
unnamed: Q2.1 (B), R6.2, R7.2
unnamed: Q2.3 (C), U2.2
unnamed: R2.1, U1.1
unnamed: R8.2, U2.1
unnamed: R10.1, U2.6
unnamed: C13.1, U3.1 (BOOT)

Notes on the sheet:
ACDET
5V -> 3V3
24V -> 5V
24V -> 12V
TRIAC2

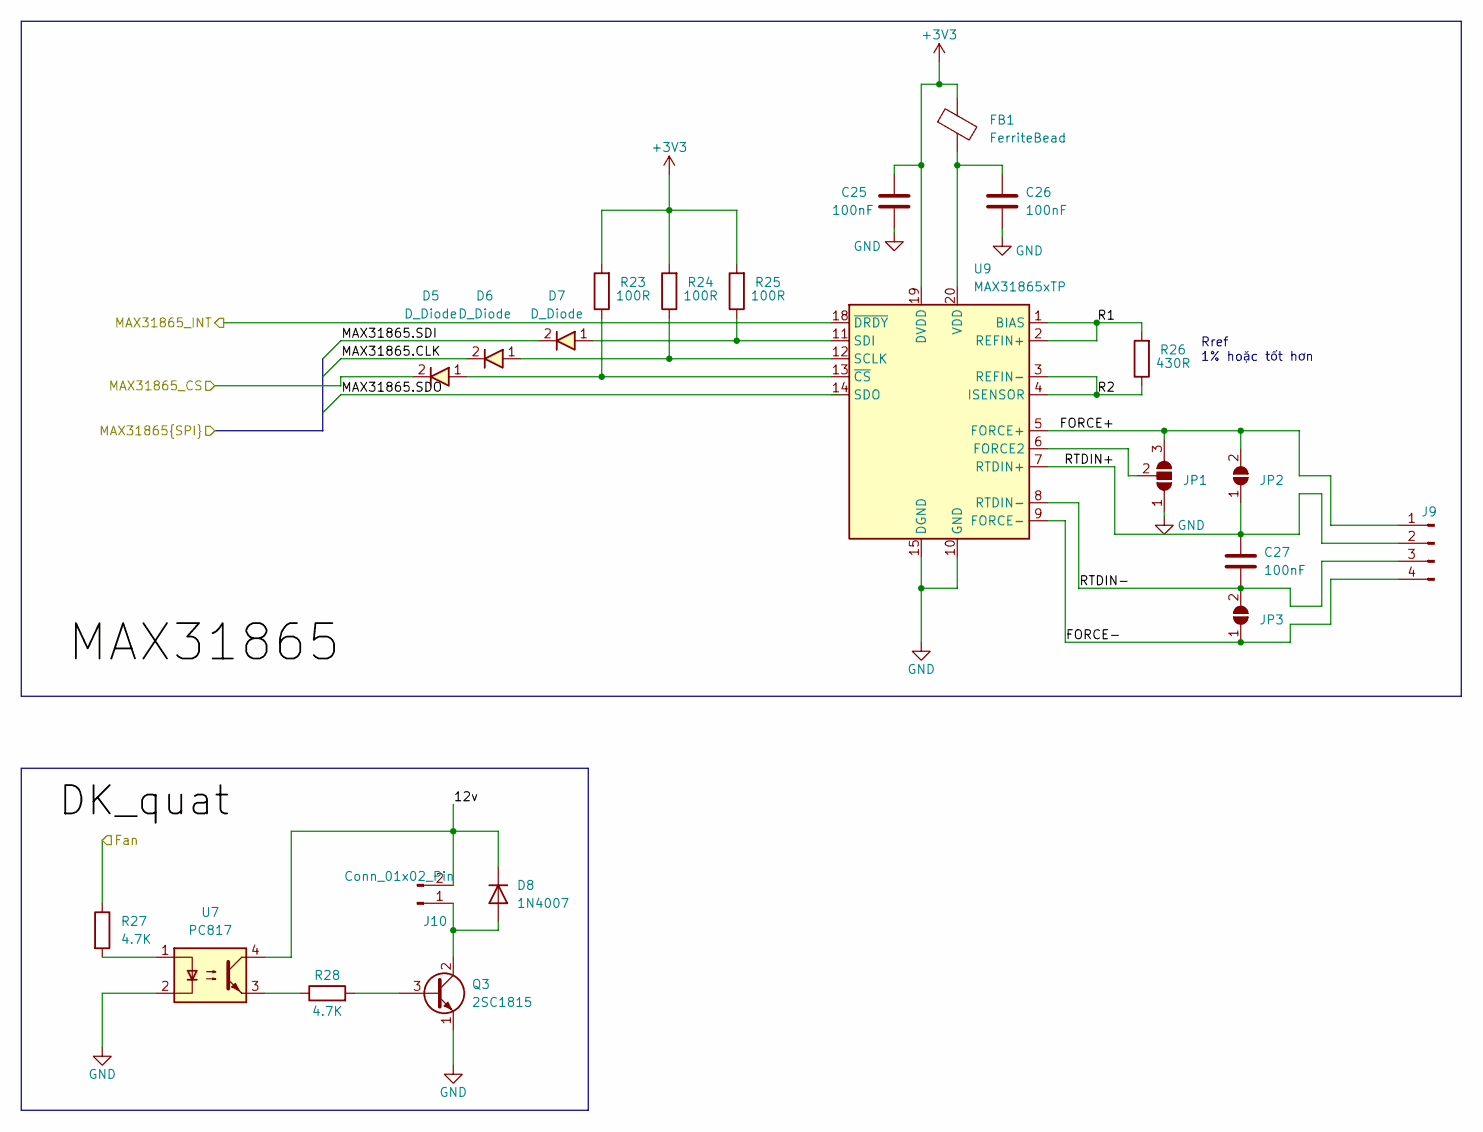
[picture p38: schematic max31865.kicad_sch, Sơ đồ chuyển đổi RTD sang Digital và điều khiển quạt]

Parts:
C25, C26, C27: 100nF; C_0603
D5, D6, D7: D_Diode; Package-Diode-D_SOD_323
D8: 1N4007; D_DO-41_SOD81_P10.16mm_Horizontal
FB1: FerriteBead; R_0805
J9: Conn_01x04_Pin; TerminalBlock_Phoenix_PT-1,5-4-5.0-H_1x04_P5.00mm_Horizontal
J10: Conn_01x02_Pin; TerminalBlock_Phoenix_PT-1,5-2-5.0-H_1x02_P5.00mm_Horizontal
JP1: SolderJumper_3_Open; SolderJumper-3_P1.3mm_Bridged12_RoundedPad1.0x1.5mm
JP2, JP3: SolderJumper_2_Open; SolderJumper-2_P1.3mm_Open_RoundedPad1.0x1.5mm
Q3: 2SC1815; TO-92_Inline
R23, R24, R25: 100R; R_0603
R26: 430R; R_0805
R27, R28: 4.7K; R_0805
U7: PC817; DIP-4_W7.62mm
U9: MAX31865xTP; TQFN-20-1EP_5x5mm_P0.65mm_EP3.25x3.25mm

Connections:
+3.3V: C25.1, FB1.1, R23.2, R24.2, R25.2, U9.19 (DVDD); also elsewhere on the board
/esp32/MAX31865.CS: D5.2; also elsewhere on the board
/esp32/esp_fan: R27.1; also elsewhere on the board
/max31865/12v: D8.1 (K), J10.2, U7.4
/max31865/FORCE+: J9.1, JP1.3 (B), JP2.2 (B), U9.5 (FORCE+)
/max31865/FORCE-: J9.4, JP3.1 (A), U9.9 (FORCE-)
/max31865/MAX31865.CLK: D6.2
/max31865/MAX31865.SDI: D7.2
/max31865/MAX31865_INT: U9.18 (~DRDY)
/max31865/R1: R26.2, U9.1 (BIAS), U9.2 (REFIN+)
/max31865/R2: R26.1, U9.3 (REFIN-), U9.4 (ISENSOR)
/max31865/RTDIN+: C27.1, J9.2, JP2.1 (A), U9.7 (RTDIN+)
/max31865/RTDIN-: C27.2, J9.3, JP3.2 (B), U9.8 (RTDIN-)
GND: C25.2, C26.2, JP1.1 (A), Q3.1 (E), U7.2, U9.10 (GND), U9.15 (DGND), U9.16 (GND), U9.21 (GND); also elsewhere on the board
unnamed: D8.2 (A), J10.1, Q3.2 (C)
unnamed: JP1.2 (C), U9.6 (FORCE2)
unnamed: Q3.3 (B), R28.2
unnamed: R27.2, U7.1
unnamed: R28.1, U7.3
unnamed: D6.1, R24.1, U9.12 (SCLK)
unnamed: D7.1, R25.1, U9.11 (SDI)
unnamed: C26.1, FB1.2, U9.20 (VDD)
unnamed: D5.1, R23.1, U9.13 (~CS)

Notes on the sheet:
Rref 1% hoặc tốt hơn

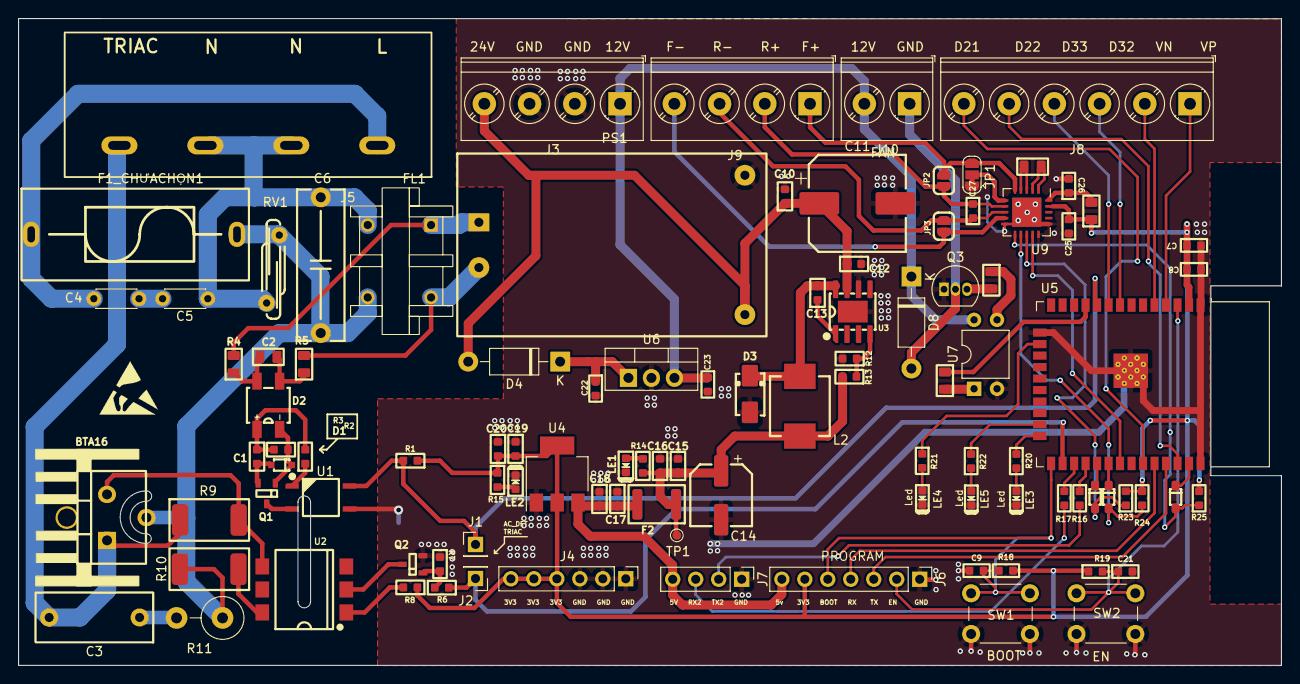
[picture p39: board board_dkth.kicad_pcb from above]

Board: 2 copper layers, 139.6 x 71.5 mm, 102 parts (0 on the bottom side), 72 nets.
