TRANQUOCHUY202/DATN/boardSTM32andESP32/boardSTM32andESP32.kicad_pcb

## KiCad design boardSTM32andESP32/boardSTM32andESP32.kicad_pcb (2024-08-06)

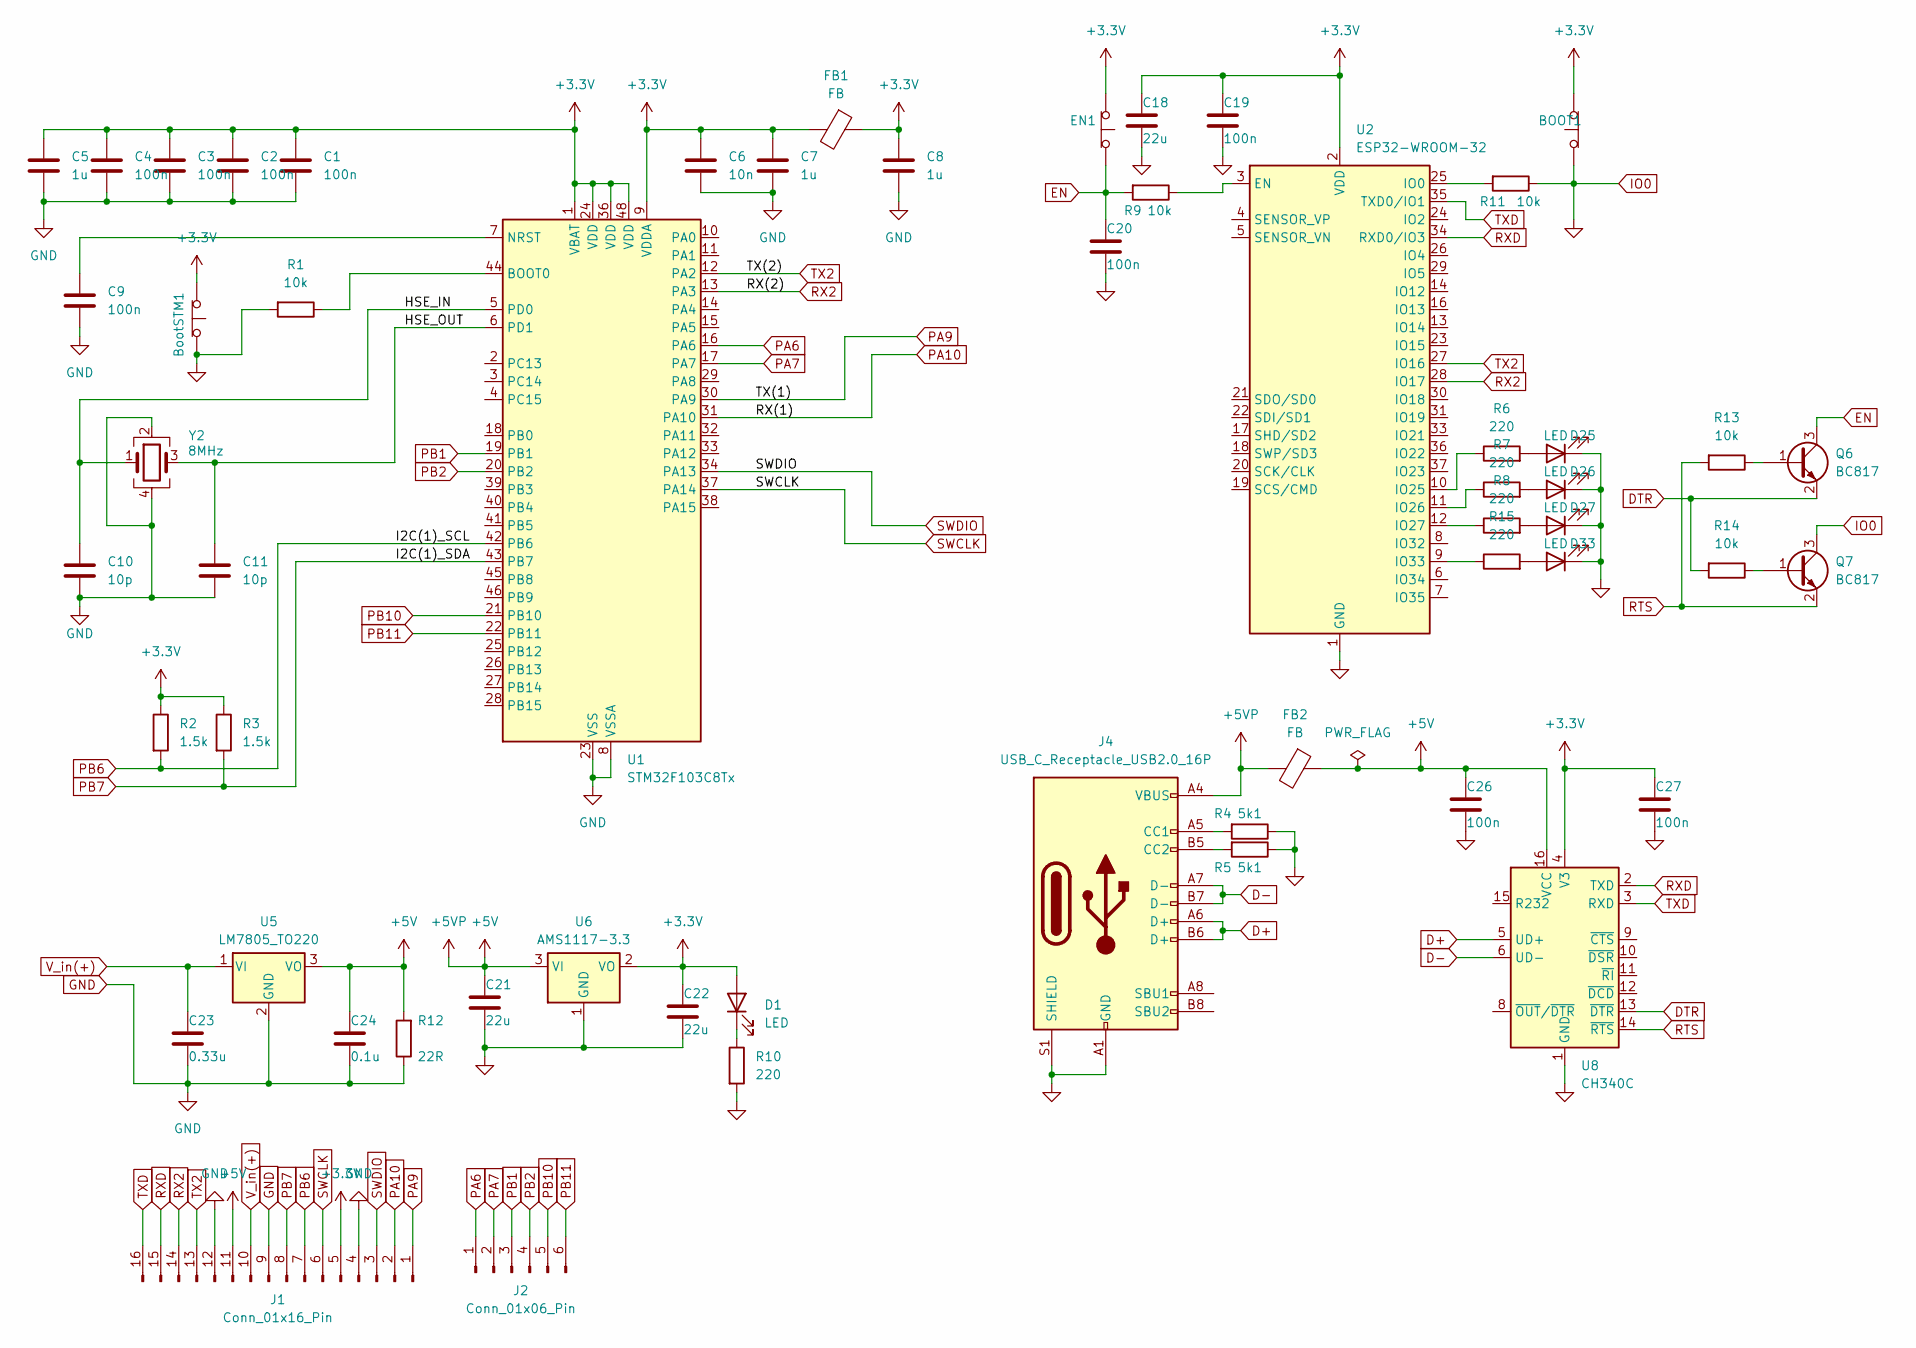
[picture p40: schematic boardSTM32andESP32.kicad_sch]

Parts:
BOOT1: SW_PUSH_6mm_H4.3mm
BootSTM1: SW_PUSH_6mm_H4.3mm
C1, C2, C3, C4, C9, C19, C20, C26, C27: 100n; C_1206_3216Metric
C5, C7, C8: 1u; C_0805_2012Metric
C6: 10n; C_0805_2012Metric
C10, C11: 10p; C_1206_3216Metric
C18, C21, C22: 22u; C_1206_3216Metric
C23: 0.33u; C_1206_3216Metric
C24: 0.1u; C_1206_3216Metric
D1, D25, D26, D27, D33: LED; LED_0805_2012Metric
EN1: SW_PUSH_6mm_H4.3mm
FB1, FB2: FB; L_0805_2012Metric
J1: Conn_01x16_Pin; TerminalBlock_Phoenix_PT-1,5-16-5.0-H_1x16_P5.00mm_Horizont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
J2: Conn_01x06_Pin; TerminalBlock_Phoenix_PT-1,5-6-5.0-H_1x06_P5.00mm_Horizontal
J4: USB_C_Receptacle_USB2.0_16P; USB_C_Receptacle_HCTL_HC-TYPE-C-16P-01A
Q6, Q7: BC817; SOT-23
R1, R9, R11, R13, R14: 10k; R_1206_3216Metric
R2, R3: 1.5k; R_1206_3216Metric
R4, R5: 5k1; R_1206_3216Metric
R6, R7, R8, R10, R15: 220; R_1206_3216Metric
R12: 22R; R_1206_3216Metric
U1: STM32F103C8Tx; LQFP-48_7x7mm_P0.5mm
U2: ESP32-WROOM-32
U5: LM7805_TO220; TO-220-3_Vertical
U6: AMS1117-3.3; SOT-223-3_TabPin2
U8: CH340C; SOP-16_3.9x9.9mm_P1.27mm
Y2: 8MHz; Crystal_SMD_5032-4Pin_5.0x3.2mm

Connections:
+3.3V: BOOT1.2 (B), BootSTM1.2 (B), C1.1, C2.1, C3.1, C4.1, C5.1, C6.1, C7.1, C8.1, C18.1, C19.1, C22.1, C27.1, D1.2 (A), EN1.2 (B), FB1.1, FB1.2, J1.5, R2.1, R3.1, U1.1 (VBAT), U1.9 (VDDA), U1.24 (VDD), U1.36 (VDD), U1.48 (VDD), U2.2 (VDD), U6.2 (VO), U8.4 (V3)
+5V: C21.1, C24.1, C26.1, FB2.1, FB2.2, J1.11, J4.A4 (VBUS), J4.A9 (VBUS), J4.B4 (VBUS), J4.B9 (VBUS), R12.2, U5.3 (VO), U6.3 (VI), U8.16 (VCC)
/HSE_IN: C10.1, U1.5 (PD0), Y2.1
/HSE_OUT: C11.1, U1.6 (PD1), Y2.3
D+: J4.A6 (D+), J4.B6 (D+), U8.5 (UD+)
D-: J4.A7 (D-), J4.B7 (D-), U8.6 (UD-)
DTR: Q6.2 (E), R14.2, U8.13 (~DTR)
EN: C20.1, EN1.1 (A), Q6.3 (C), R9.2
GND: BOOT1.1 (A), BootSTM1.1 (A), C1.2, C2.2, C3.2, C4.2, C5.2, C6.2, C7.2, C8.2, C9.2, C10.2, C11.2, C18.2, C19.2, C20.2, C21.2, C22.2, C23.2, C24.2, C26.2, C27.2, D25.1 (K), D26.1 (K), D27.1 (K), D33.1 (K), J1.4, J1.9, J1.12, J4.A1 (GND), J4.A12 (GND), J4.B1 (GND), J4.B12 (GND), J4.S1 (SHIELD), Q7.3 (C), R1.2, R4.1, R5.1, R10.2, R11.1, R12.1, U1.8 (VSSA), U1.23 (VSS), U1.35 (VSS), U1.47 (VSS), U2.1 (GND), U2.15 (GND), U2.38 (GND), U2.39 (GND), U5.2 (GND), U6.1 (GND), U8.1 (GND), Y2.2, Y2.4
unnamed: D1.1 (K), R10.1
unnamed: D25.2 (A), R6.2
unnamed: D26.2 (A), R7.2
unnamed: D27.2 (A), R8.2
unnamed: D33.2 (A), R15.2
unnamed: J4.A5 (CC1), R4.2
unnamed: J4.B5 (CC2), R5.2
unnamed: Q6.1 (B), R13.1
unnamed: Q7.1 (B), R14.1
unnamed: R1.1, U1.44 (BOOT0)
unnamed: C9.1, U1.7 (NRST)
unnamed: R9.1, U2.3 (EN)
unnamed: R11.2, U2.25 (IO0)
unnamed: R6.1, U2.10 (IO25)
unnamed: R7.1, U2.11 (IO26)
unnamed: R8.1, U2.12 (IO27)
unnamed: R15.1, U2.9 (IO33)
PA6: J2.1, U1.16 (PA6)
PA7: J2.2, U1.17 (PA7)
PA9: J1.1, U1.30 (PA9)
PA10: J1.2, U1.31 (PA10)
PB1: J2.3, U1.19 (PB1)
PB2: J2.4, U1.20 (PB2)
PB6: J1.7, R2.2, U1.42 (PB6)
PB7: J1.8, R3.2, U1.43 (PB7)
PB10: J2.5, U1.21 (PB10)
PB11: J2.6, U1.22 (PB11)
RTS: Q7.2 (E), R13.2, U8.14 (~RTS)
RX2: J1.14, U1.13 (PA3), U2.28 (IO17)
RXD: J1.15, U2.34 (RXD0/IO3), U8.2 (TXD)
SWCLK: J1.6, U1.37 (PA14)
SWDIO: J1.3, U1.34 (PA13)
TX2: J1.13, U1.12 (PA2), U2.27 (IO16)
TXD: J1.16, U2.35 (TXD0/IO1), U8.3 (RXD)
V_in(+): C23.1, J1.10, U5.1 (VI)

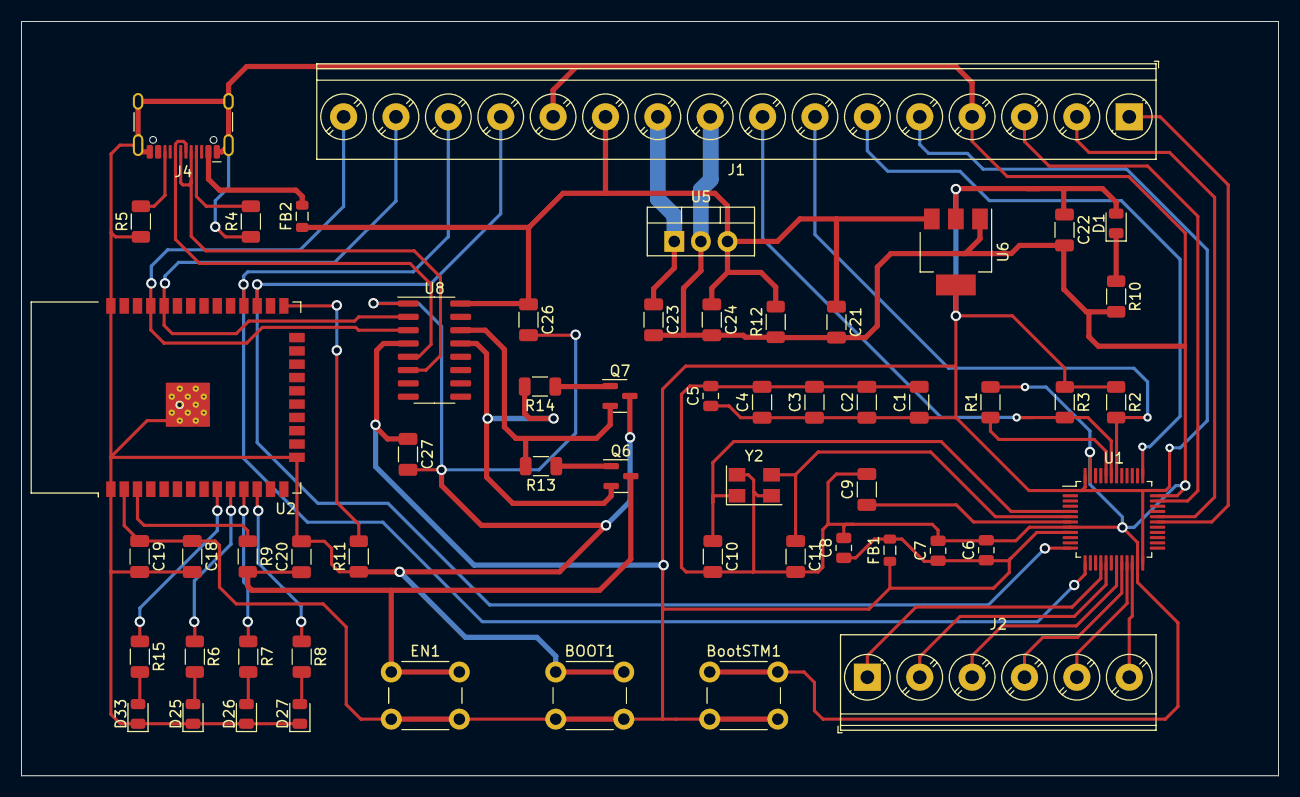
[picture p41: board boardSTM32andESP32.kicad_pcb from above]

Board: 2 copper layers, 120.0 x 72.0 mm, 56 parts (0 on the bottom side), 44 nets.
